ruslanrobotic/Dissertation/Test bench/3DModel_CAD_CAE/Version without libraries/Baugruppe_026.JPG

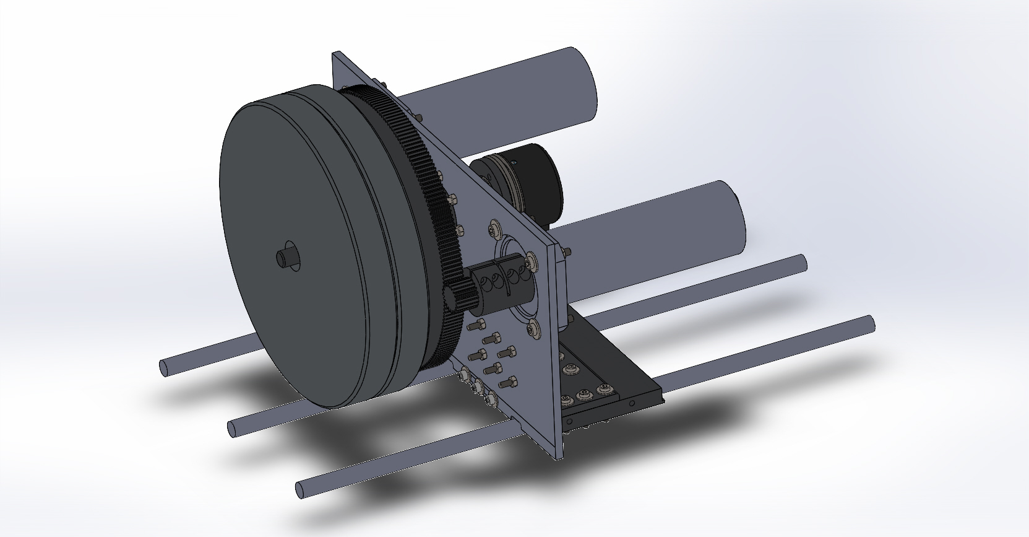
Test bench/3DModel_CAD_CAE/Version without libraries/Baugruppe_026.JPG
