ruslanrobotic/Dissertation/Test bench/3DModel_CAD_CAE/Baugruppe_026.JPG

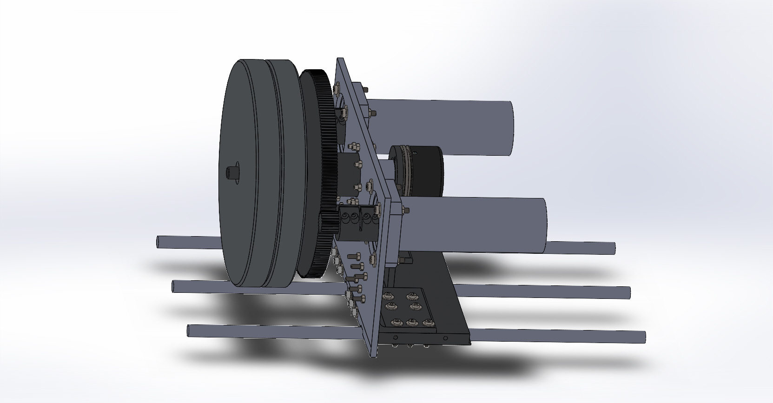
Test bench/3DModel_CAD_CAE/Baugruppe_026.JPG
