ruslanrobotic/Dissertation/Test bench/3DModel_CAD_CAE/Baugruppe_026.SLDASM

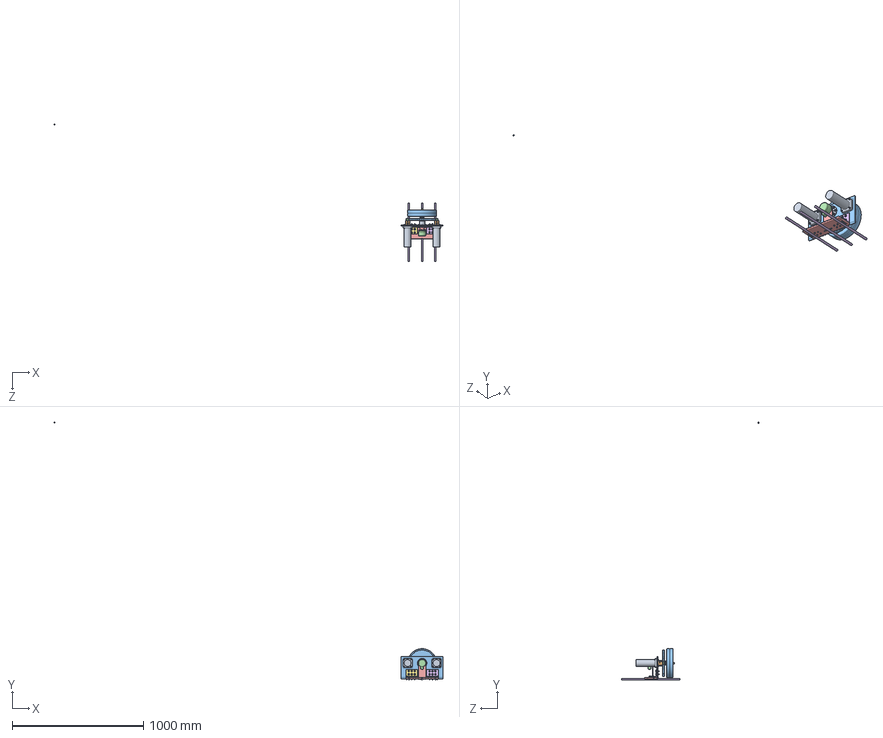
[picture p31: CAD file, 2025-05-02]
Test bench/3DModel_CAD_CAE/Baugruppe_026.SLDASM
2962.5 x 1963.3 x 1046.3 mm
Двигатель KEB B2.SM.000-6200_01 x 2
Вал_двигателя_01 x 2
Platform_001
Circlips 13943A_gost x 2
Bear 8338_200_gost x 2
Bush_2
Shaft_4
Circlips 13942B_gost
Frame_small_stand_2
Washer 6958_1_gost x 51
socket thin pilot cap screw_din x 42
Hex Nut 5929_gost x 8
Platform_2_001
Rail_1 x 3
Washer 6402_3_gost x 6
SC GOST 11738_gost x 10
KTR_105_9_20 x 2
KTR 105_15_28_2
Gear_small_2
Gear_001_i=10_small_z=20 x 2
Sensor_support x 2
Angle_bar
Angle_bar_2
Hex Nut 5915_gost x 35
SC GOST 1491_gost x 3
Kuppling_001 x 2
Load_1 x 2
Sensor
Sensor_clutch
Sensor_shaft
