ruslanrobotic/Dissertation/Test bench/3DModel_CAD_CAE/Version without libraries/Baugruppe_027.SLDASM

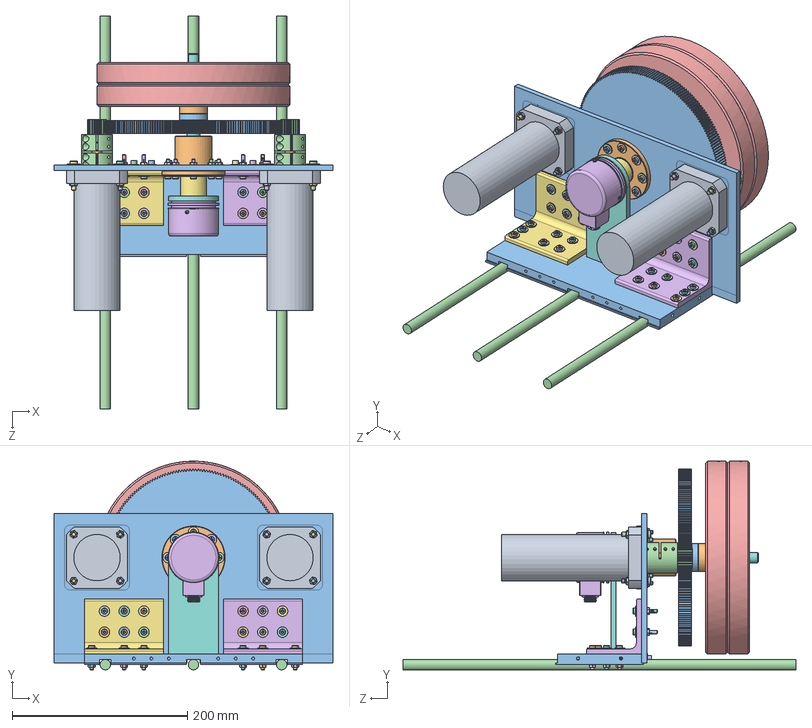
[picture p32: CAD file, 2025-05-02]
Test bench/3DModel_CAD_CAE/Version without libraries/Baugruppe_027.SLDASM
318.0 x 238.0 x 448.0 mm
Двигатель KEB B2.SM.000-6200_01 x 2
Вал_двигателя_01 x 2
Platform_001
Circlips 13943A_gost_2
Bear 8338_200_gost_2
Bear 8338_200_gost_3
Bush_2
Shaft_4
Circlips 13942B_gost_2
Frame_small_stand_2
Washer 6958_1_gost_2
Washer 6958_1_gost_3
Washer 6958_1_gost_4
Washer 6958_1_gost_5
Washer 6958_1_gost_6
Washer 6958_1_gost_7
Washer 6958_1_gost_8
Washer 6958_1_gost_9
socket thin pilot cap screw_din_2
socket thin pilot cap screw_din_3
socket thin pilot cap screw_din_4
socket thin pilot cap screw_din_5
socket thin pilot cap screw_din_6
socket thin pilot cap screw_din_7
socket thin pilot cap screw_din_8
socket thin pilot cap screw_din_9
Hex Nut 5929_gost_2
Hex Nut 5929_gost_3
Hex Nut 5929_gost_4
Hex Nut 5929_gost_5
Hex Nut 5929_gost_6
Hex Nut 5929_gost_7
Hex Nut 5929_gost_8
Hex Nut 5929_gost_9
Platform_2_001
Rail_1 x 3
Washer 6402_3_gost_2
Washer 6402_3_gost_3
Washer 6402_3_gost_4
Washer 6402_3_gost_5
Washer 6402_3_gost_6
Washer 6402_3_gost_7
SC GOST 11738_gost_2
SC GOST 11738_gost_3
SC GOST 11738_gost_4
SC GOST 11738_gost_5
SC GOST 11738_gost_6
SC GOST 11738_gost_7
KTR_105_9_20 x 2
KTR 105_15_28_2
Gear_small_2
Gear_001_i=10_small_z=20 x 2
Circlips 13943A_gost_3
Angle_bar
Angle_bar_2
Washer 6958_1_gost_10
Washer 6958_1_gost_11
Washer 6958_1_gost_12
Washer 6958_1_gost_13
Washer 6958_1_gost_14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
