ruslanrobotic/Dissertation/Test bench/3DModel_CAD_CAE/Shaft_4.SLDPRT

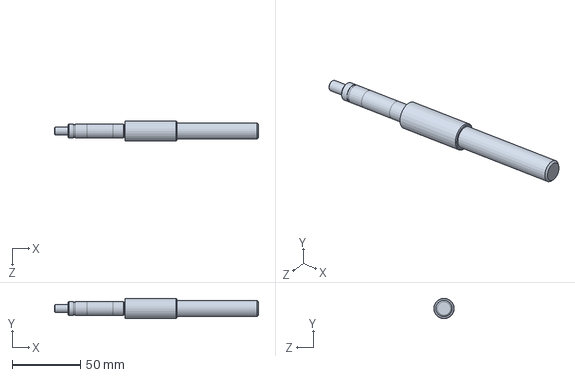
[picture p33: CAD file, 2025-05-02]
Test bench/3DModel_CAD_CAE/Shaft_4.SLDPRT
150.0 x 15.0 x 15.0 mm
