ruslanrobotic/Dissertation/Test bench/3DModel_CAD_CAE/Load_1.SLDPRT

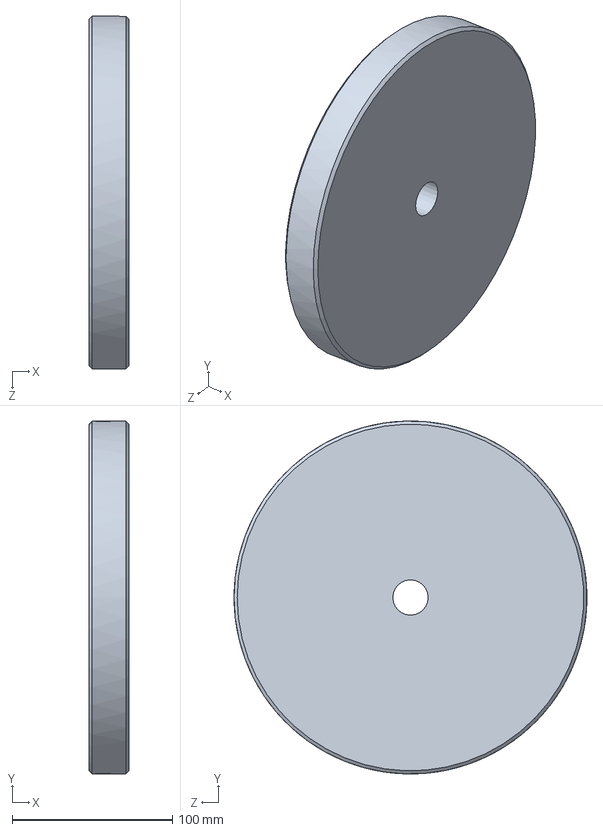
[picture p34: CAD file, 2025-05-02]
Test bench/3DModel_CAD_CAE/Load_1.SLDPRT
25.0 x 219.9 x 220.0 mm
