ruslanrobotic/Dissertation/Test bench/3DModel_CAD_CAE/Angle_bar_2.SLDPRT

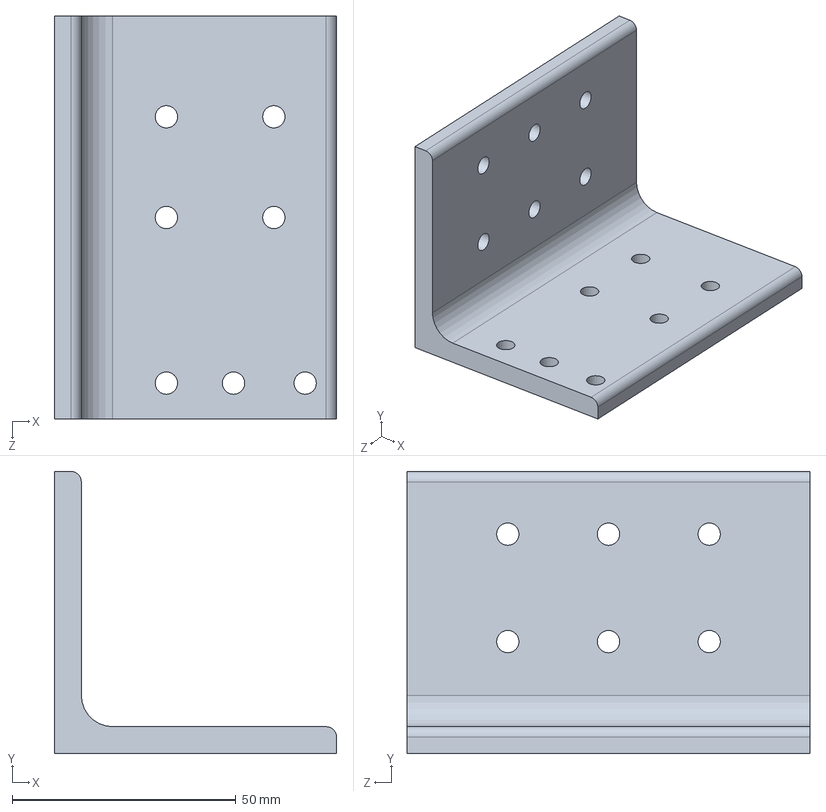
[picture p35: CAD file, 2025-05-02]
Test bench/3DModel_CAD_CAE/Angle_bar_2.SLDPRT
63.0 x 63.0 x 90.0 mm
