ruslanrobotic/Dissertation/Test bench/3DModel_CAD_CAE/Version without libraries/SC GOST 11738_gost_3.SLDPRT

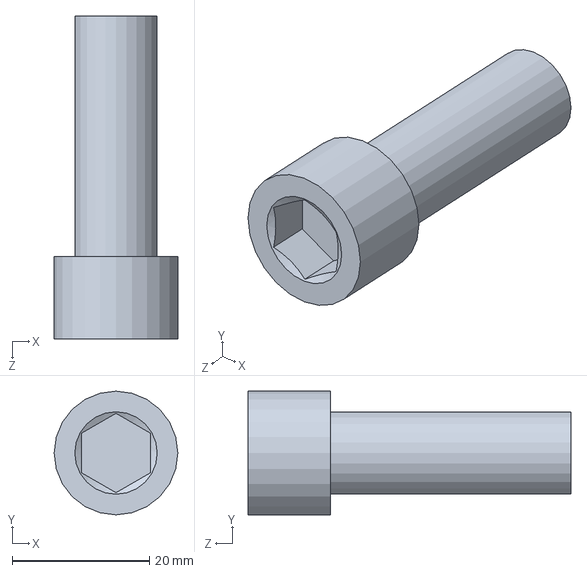
[picture p36: CAD file, 2025-05-02]
Test bench/3DModel_CAD_CAE/Version without libraries/SC GOST 11738_gost_3.SLDPRT
18.0 x 18.0 x 47.0 mm
