ruslanrobotic/Dissertation/Test bench/3DModel_CAD_CAE/Gear_small_2.SLDPRT

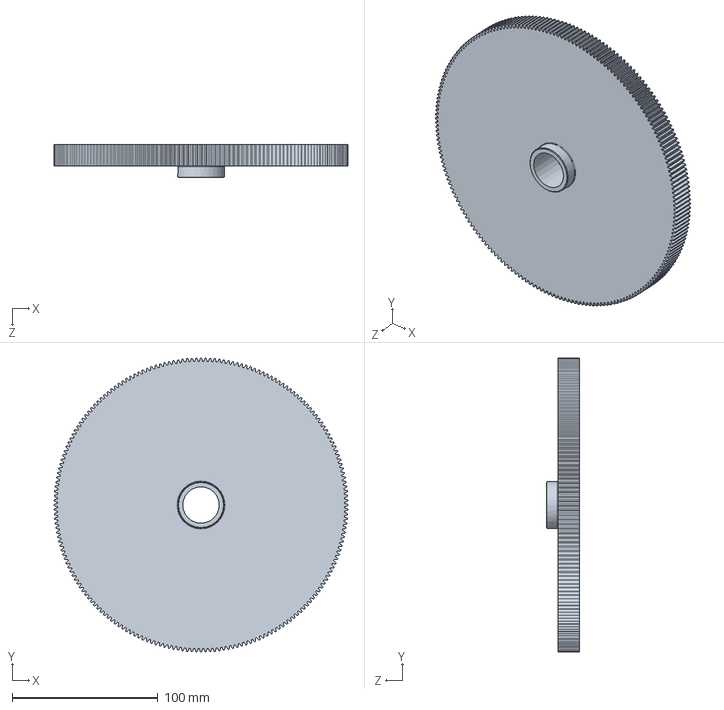
[picture p37: CAD file, 2025-05-02]
Test bench/3DModel_CAD_CAE/Gear_small_2.SLDPRT
202.0 x 202.0 x 23.0 mm
