ruslanrobotic/Dissertation/Test bench/3DModel_CAD_CAE/Sensor_support.SLDPRT

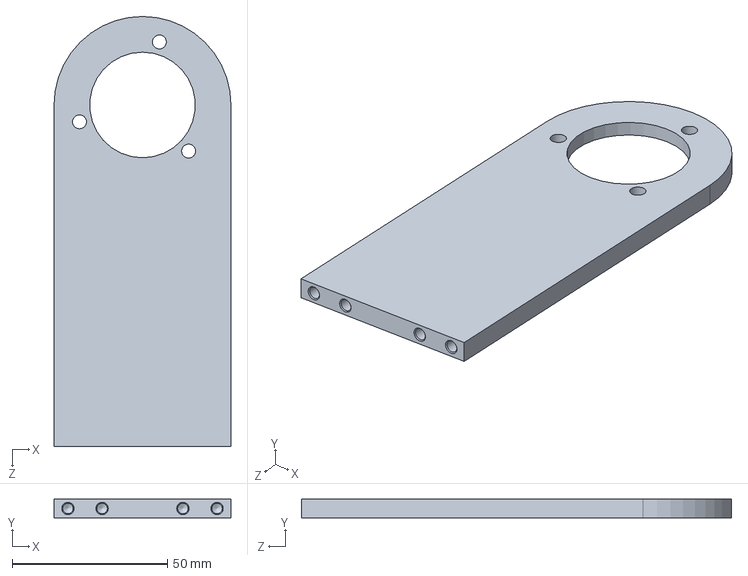
[picture p38: CAD file, 2025-05-02]
Test bench/3DModel_CAD_CAE/Sensor_support.SLDPRT
57.0 x 6.00 x 138.5 mm
