ruslanrobotic/Dissertation/Test bench/3DModel_CAD_CAE/Platform_2_001.SLDPRT

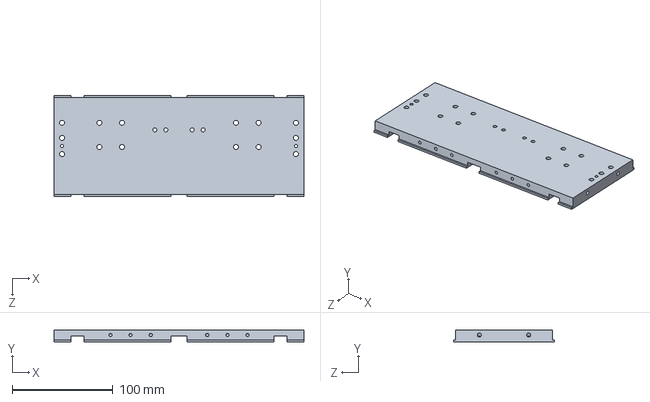
[picture p39: CAD file, 2025-05-02]
Test bench/3DModel_CAD_CAE/Platform_2_001.SLDPRT
248.0 x 12.0 x 100.0 mm
