ruslanrobotic/Dissertation/Test bench/3DModel_CAD_CAE/Version without libraries/Sensor_shaft.SLDPRT

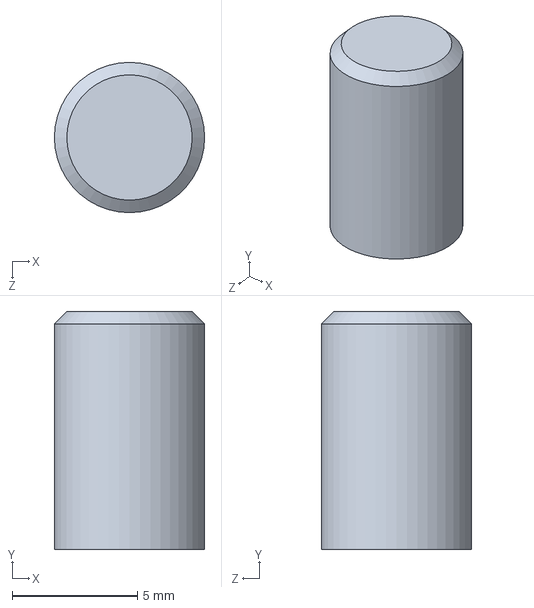
[picture p40: CAD file, 2025-05-02]
Test bench/3DModel_CAD_CAE/Version without libraries/Sensor_shaft.SLDPRT
6.00 x 9.50 x 6.00 mm
