ruslanrobotic/Dissertation/Test bench/3DModel_CAD_CAE/Sensor_clutch.SLDPRT

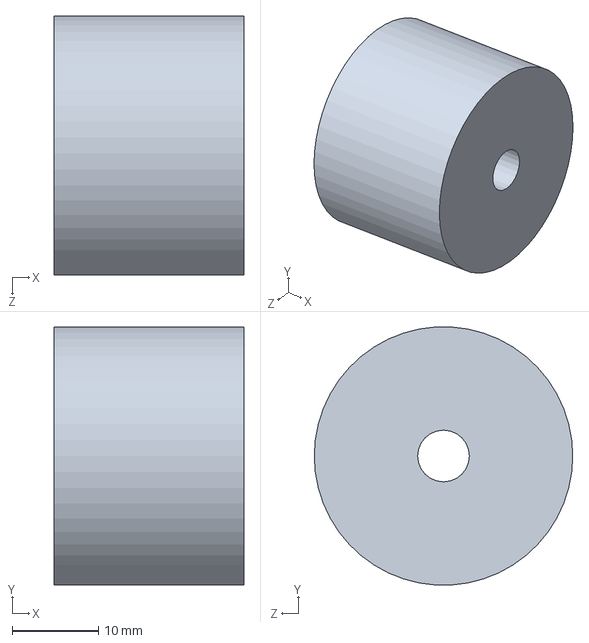
[picture p41: CAD file, 2025-05-02]
Test bench/3DModel_CAD_CAE/Sensor_clutch.SLDPRT
22.0 x 29.9 x 30.0 mm
