ruslanrobotic/Dissertation/Test bench/3DModel_CAD_CAE/Bush_2.SLDPRT

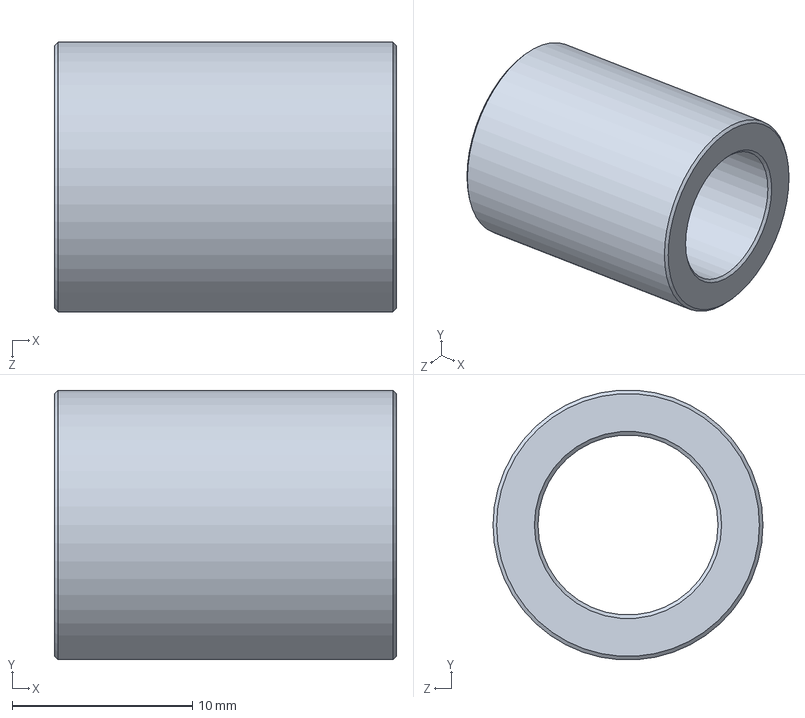
[picture p42: CAD file, 2025-05-02]
Test bench/3DModel_CAD_CAE/Bush_2.SLDPRT
19.0 x 15.0 x 15.0 mm
