ruslanrobotic/Dissertation/Test bench/3DModel_CAD_CAE/Platform_001.SLDPRT

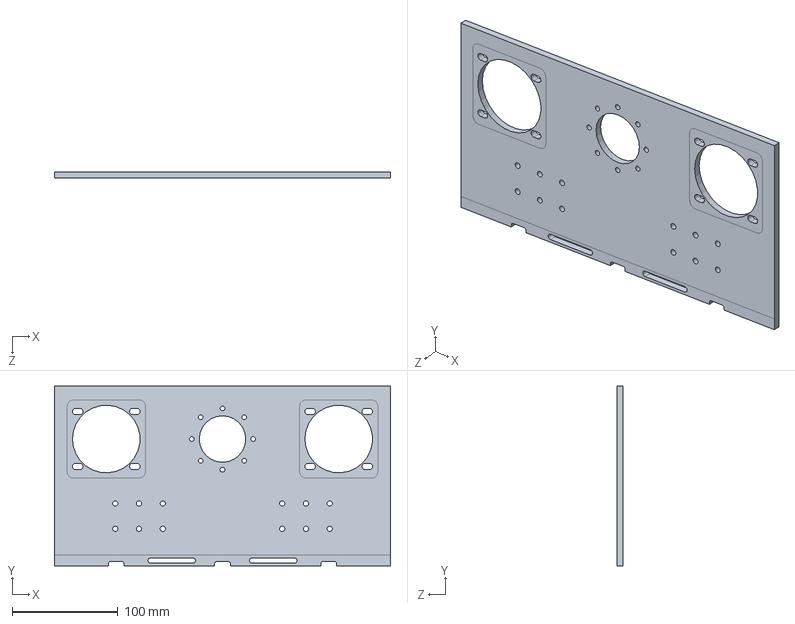
[picture p43: CAD file, 2025-05-02]
Test bench/3DModel_CAD_CAE/Platform_001.SLDPRT
318.0 x 170.0 x 6.00 mm
