ruslanrobotic/Dissertation/Test bench/3DModel_CAD_CAE/Circlips 13942B_gost.SLDPRT

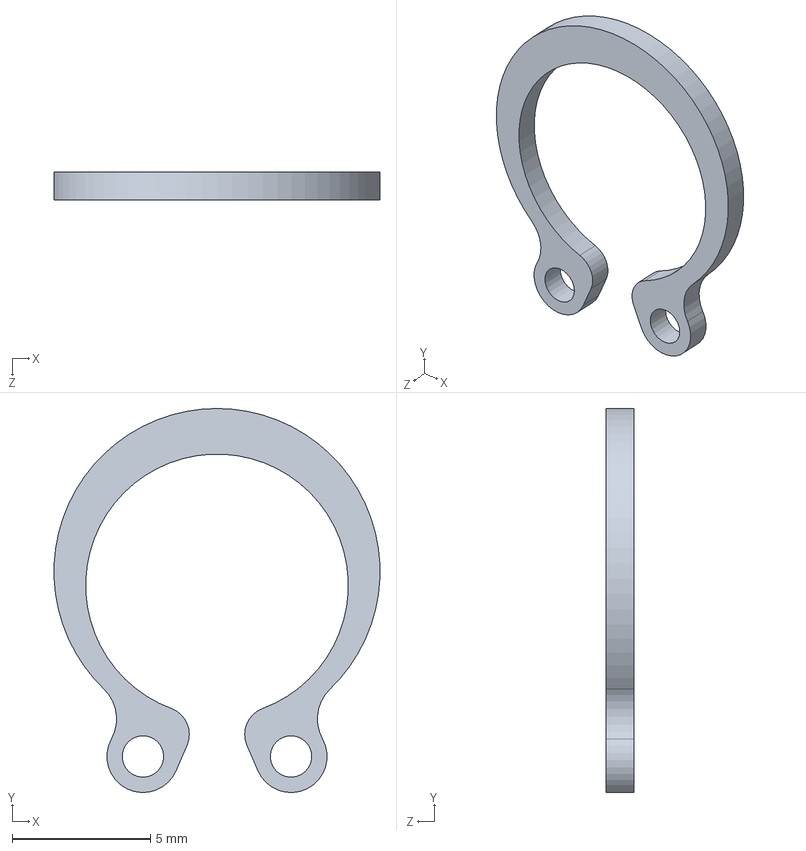
[picture p44: CAD file, 2025-05-02]
Test bench/3DModel_CAD_CAE/Circlips 13942B_gost.SLDPRT
11.8 x 13.9 x 1.00 mm
