ruslanrobotic/Dissertation/Test bench/3DModel_CAD_CAE/Rail_1.SLDPRT

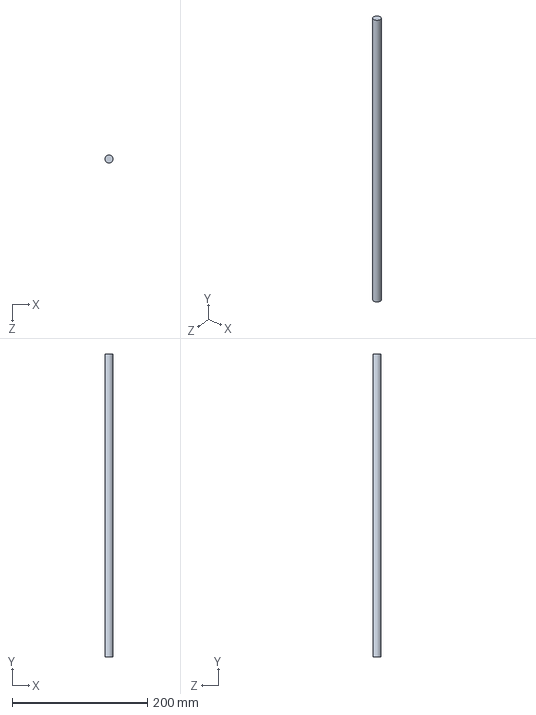
[picture p45: CAD file, 2025-05-02]
Test bench/3DModel_CAD_CAE/Rail_1.SLDPRT
12.0 x 448.0 x 12.0 mm
