ruslanrobotic/Dissertation/Test bench/3DModel_CAD_CAE/Version without libraries/Bear 8338_200_gost_2.SLDPRT

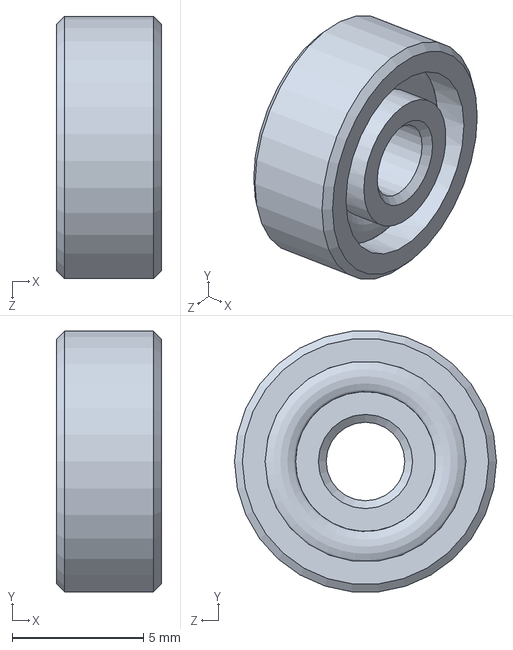
[picture p46: CAD file, 2025-05-02]
Test bench/3DModel_CAD_CAE/Version without libraries/Bear 8338_200_gost_2.SLDPRT
4.00 x 9.95 x 10.0 mm
