ruslanrobotic/Dissertation/Test bench/3DModel_CAD_CAE/Kuppling_001.SLDPRT

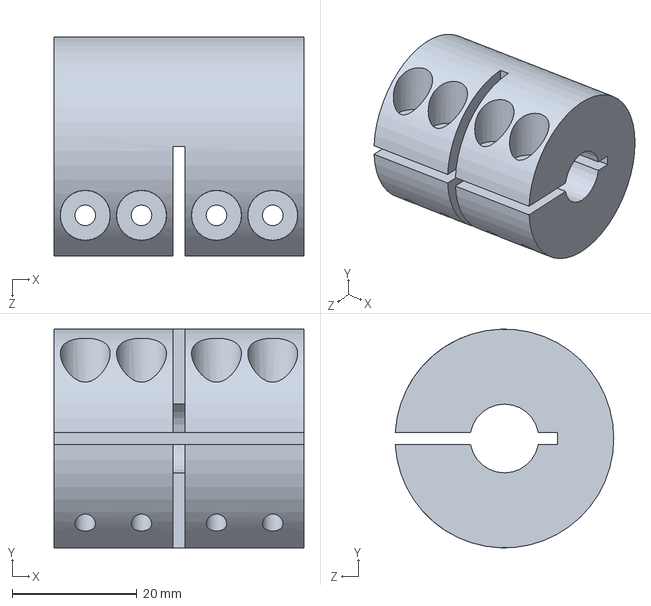
[picture p47: CAD file, 2025-05-02]
Test bench/3DModel_CAD_CAE/Kuppling_001.SLDPRT
40.0 x 35.0 x 35.0 mm
