ruslanrobotic/Dissertation/Test bench/3DModel_CAD_CAE/SC GOST 1491_gost.SLDPRT

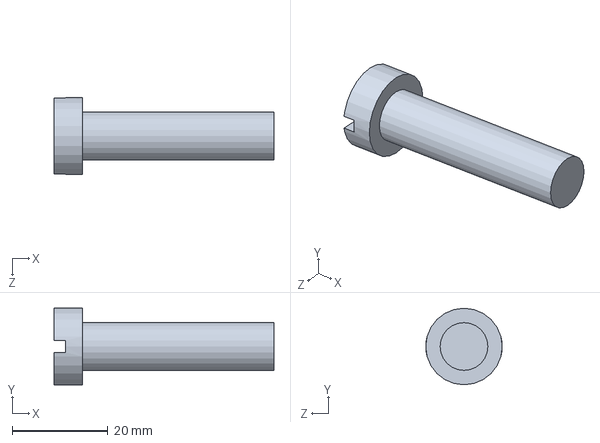
[picture p48: CAD file, 2025-05-02]
Test bench/3DModel_CAD_CAE/SC GOST 1491_gost.SLDPRT
46.0 x 16.0 x 16.0 mm
