ruslanrobotic/Dissertation/Test bench/3DModel_CAD_CAE/Version without libraries/KTR 105_15_28_2.SLDPRT

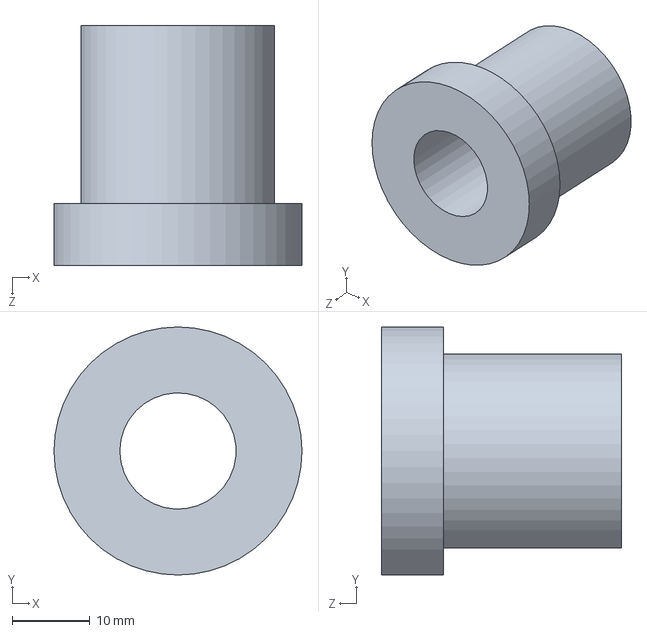
[picture p49: CAD file, 2025-05-02]
Test bench/3DModel_CAD_CAE/Version without libraries/KTR 105_15_28_2.SLDPRT
32.0 x 32.0 x 31.0 mm
