ruslanrobotic/Dissertation/Test bench/3DModel_CAD_CAE/Sensor.SLDPRT

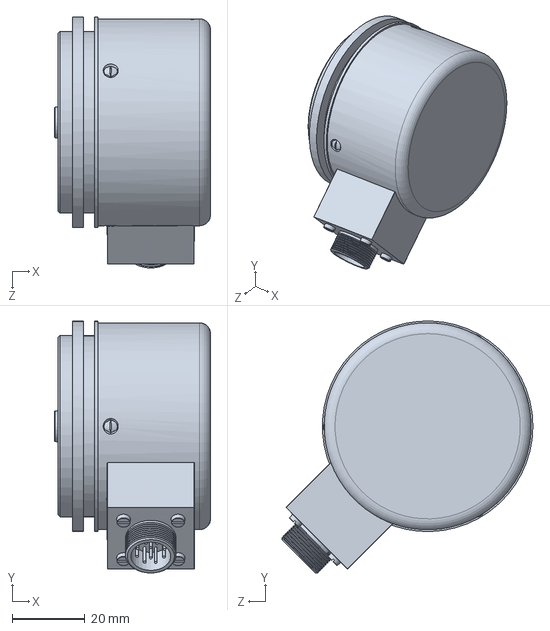
[picture p50: CAD file, 2025-05-02]
Test bench/3DModel_CAD_CAE/Sensor.SLDPRT
43.0 x 69.4 x 69.1 mm
