ruslanrobotic/Dissertation/Test bench/3DModel_CAD_CAE/KTR_105_9_20.SLDPRT

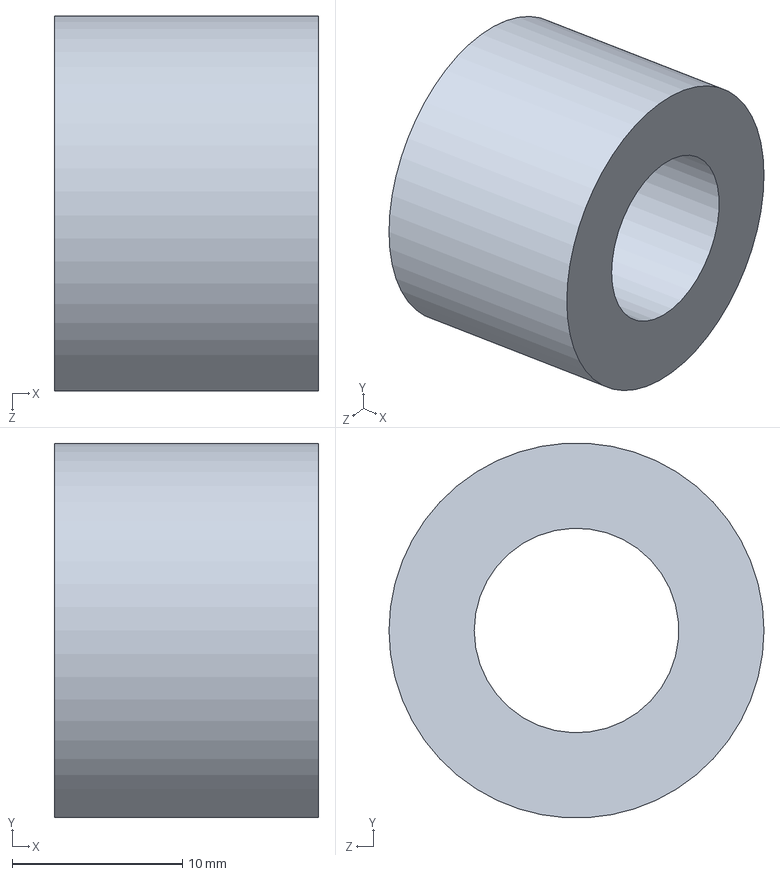
[picture p51: CAD file, 2025-05-02]
Test bench/3DModel_CAD_CAE/KTR_105_9_20.SLDPRT
15.5 x 22.0 x 22.0 mm
