ruslanrobotic/Dissertation/Test bench/3DModel_CAD_CAE/Circlips 13943A_gost.SLDPRT

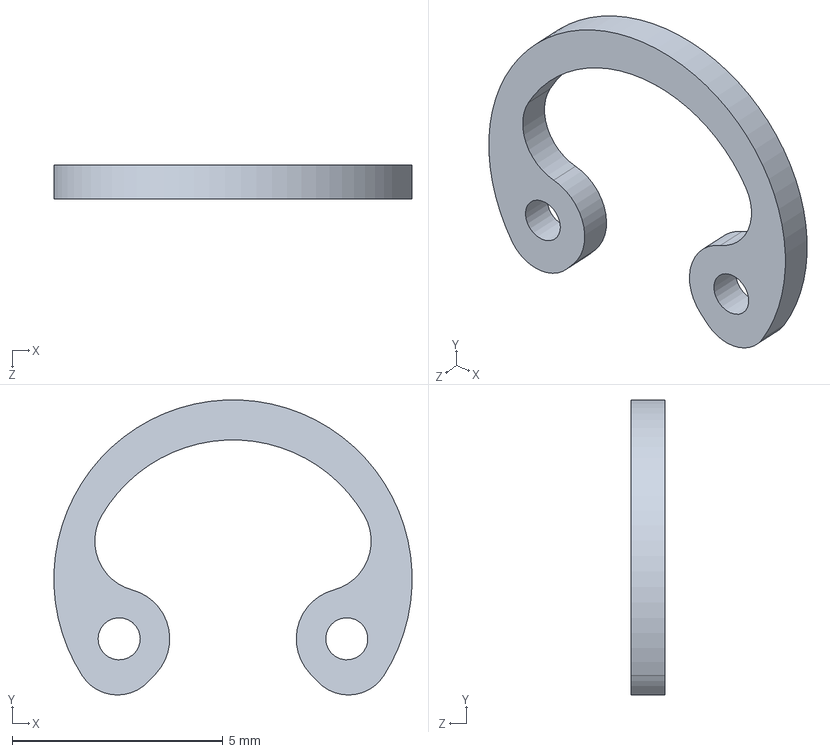
[picture p52: CAD file, 2025-05-02]
Test bench/3DModel_CAD_CAE/Circlips 13943A_gost.SLDPRT
8.49 x 7.00 x 0.8 mm
