ruslanrobotic/Dissertation/Test bench/3DModel_CAD_CAE/Frame_small_stand_2.SLDPRT

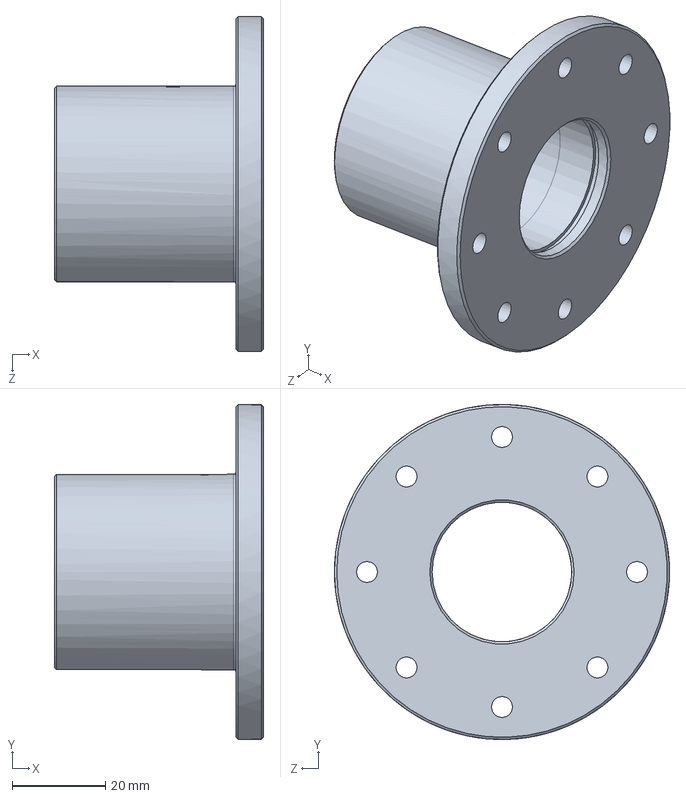
[picture p53: CAD file, 2025-05-02]
Test bench/3DModel_CAD_CAE/Frame_small_stand_2.SLDPRT
45.0 x 72.0 x 72.0 mm
