ruslanrobotic/Dissertation/Test bench/3DModel_CAD_CAE/Gear_001_i=10_small_z=20.SLDPRT

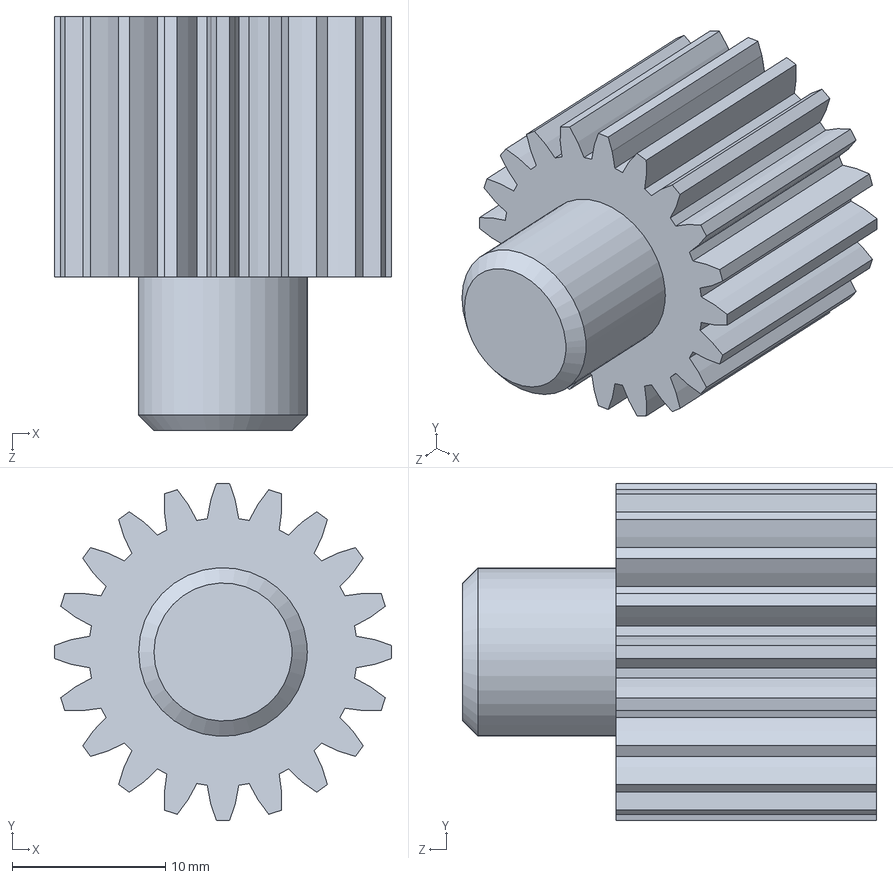
[picture p54: CAD file, 2025-05-02]
Test bench/3DModel_CAD_CAE/Gear_001_i=10_small_z=20.SLDPRT
22.0 x 22.0 x 27.0 mm
