ruslanrobotic/Dissertation/(list of files, cad)

Other CAD files:
Test bench/3DModel_CAD_CAE/Version without libraries/Baugruppe_026.SLDASM
Test bench/3DModel_CAD_CAE/Вал_двигателя_01.SLDPRT
Test bench/3DModel_CAD_CAE/Version without libraries/Angle_bar.SLDPRT
Test bench/3DModel_CAD_CAE/Двигатель KEB B2.SM.000-6200_01.SLDPRT
Test bench/3DModel_CAD_CAE/Bear 8338_200_gost.SLDPRT
Test bench/3DModel_CAD_CAE/SC GOST 11738_gost.SLDPRT
Test bench/3DModel_CAD_CAE/Version without libraries/SC GOST 11738_gost_5.SLDPRT
Test bench/3DModel_CAD_CAE/Version without libraries/SC GOST 11738_gost_4.SLDPRT
Test bench/3DModel_CAD_CAE/Angle_bar.SLDPRT
Test bench/3DModel_CAD_CAE/Version without libraries/Двигатель KEB B2.SM.000-6200_01.SLDPRT
Test bench/3DModel_CAD_CAE/Version without libraries/Circlips 13942B_gost_2.SLDPRT
Test bench/3DModel_CAD_CAE/Version without libraries/SC GOST 11738_gost_2.SLDPRT
Test bench/3DModel_CAD_CAE/Version without libraries/Circlips 13943A_gost_3.SLDPRT
Test bench/3DModel_CAD_CAE/Version without libraries/SC GOST 11738_gost_7.SLDPRT
Test bench/3DModel_CAD_CAE/Version without libraries/SC GOST 11738_gost_6.SLDPRT
Test bench/3DModel_CAD_CAE/Version without libraries/Kuppling_001.SLDPRT
Test bench/3DModel_CAD_CAE/Version without libraries/Circlips 13943A_gost_2.SLDPRT
Test bench/3DModel_CAD_CAE/Version without libraries/Bear 8338_200_gost.SLDPRT
Test bench/3DModel_CAD_CAE/Version without libraries/Bear 8338_200_gost_3.SLDPRT
Test bench/3DModel_CAD_CAE/Version without libraries/Вал_двигателя_01.SLDPRT
Test bench/3DModel_CAD_CAE/Hex Nut 5915_gost.SLDPRT
Test bench/3DModel_CAD_CAE/Hex Nut 5929_gost.SLDPRT
Test bench/3DModel_CAD_CAE/Version without libraries/Hex Nut 5915_gost.SLDPRT
Test bench/3DModel_CAD_CAE/Version without libraries/Hex Nut 5915_gost_10.SLDPRT
Test bench/3DModel_CAD_CAE/Version without libraries/Hex Nut 5915_gost_11.SLDPRT
Test bench/3DModel_CAD_CAE/Version without libraries/Hex Nut 5915_gost_12.SLDPRT
Test bench/3DModel_CAD_CAE/Version without libraries/Hex Nut 5915_gost_13.SLDPRT
Test bench/3DModel_CAD_CAE/Version without libraries/Hex Nut 5915_gost_14.SLDPRT
Test bench/3DModel_CAD_CAE/Version without libraries/Hex Nut 5915_gost_15.SLDPRT
Test bench/3DModel_CAD_CAE/Version without libraries/Hex Nut 5915_gost_16.SLDPRT
Test bench/3DModel_CAD_CAE/Version without libraries/Hex Nut 5915_gost_17.SLDPRT
Test bench/3DModel_CAD_CAE/Version without libraries/Hex Nut 5915_gost_18.SLDPRT
Test bench/3DModel_CAD_CAE/Version without libraries/Hex Nut 5915_gost_19.SLDPRT
Test bench/3DModel_CAD_CAE/Version without libraries/Hex Nut 5915_gost_2.SLDPRT
Test bench/3DModel_CAD_CAE/Version without libraries/Hex Nut 5915_gost_20.SLDPRT
Test bench/3DModel_CAD_CAE/Version without libraries/Hex Nut 5915_gost_21.SLDPRT
Test bench/3DModel_CAD_CAE/Version without libraries/Hex Nut 5915_gost_22.SLDPRT
Test bench/3DModel_CAD_CAE/Version without libraries/Hex Nut 5915_gost_23.SLDPRT
Test bench/3DModel_CAD_CAE/Version without libraries/Hex Nut 5915_gost_24.SLDPRT
Test bench/3DModel_CAD_CAE/Version without libraries/Hex Nut 5915_gost_25.SLDPRT
Test bench/3DModel_CAD_CAE/Version without libraries/Hex Nut 5915_gost_26.SLDPRT
Test bench/3DModel_CAD_CAE/Version without libraries/Hex Nut 5915_gost_27.SLDPRT
Test bench/3DModel_CAD_CAE/Version without libraries/Hex Nut 5915_gost_28.SLDPRT
Test bench/3DModel_CAD_CAE/Version without libraries/Hex Nut 5915_gost_29.SLDPRT
Test bench/3DModel_CAD_CAE/Version without libraries/Hex Nut 5915_gost_3.SLDPRT
Test bench/3DModel_CAD_CAE/Version without libraries/Hex Nut 5915_gost_30.SLDPRT
Test bench/3DModel_CAD_CAE/Version without libraries/Hex Nut 5915_gost_31.SLDPRT
Test bench/3DModel_CAD_CAE/Version without libraries/Hex Nut 5915_gost_32.SLDPRT
Test bench/3DModel_CAD_CAE/Version without libraries/Hex Nut 5915_gost_33.SLDPRT
Test bench/3DModel_CAD_CAE/Version without libraries/Hex Nut 5915_gost_34.SLDPRT
Test bench/3DModel_CAD_CAE/Version without libraries/Hex Nut 5915_gost_35.SLDPRT
Test bench/3DModel_CAD_CAE/Version without libraries/Hex Nut 5915_gost_4.SLDPRT
Test bench/3DModel_CAD_CAE/Version without libraries/Hex Nut 5915_gost_5.SLDPRT
Test bench/3DModel_CAD_CAE/Version without libraries/Hex Nut 5915_gost_6.SLDPRT
Test bench/3DModel_CAD_CAE/Version without libraries/Hex Nut 5915_gost_7.SLDPRT
Test bench/3DModel_CAD_CAE/Version without libraries/Hex Nut 5915_gost_8.SLDPRT
Test bench/3DModel_CAD_CAE/Version without libraries/Hex Nut 5915_gost_9.SLDPRT
Test bench/3DModel_CAD_CAE/Version without libraries/Hex Nut 5929_gost.SLDPRT
Test bench/3DModel_CAD_CAE/Version without libraries/Hex Nut 5929_gost_2.SLDPRT
Test bench/3DModel_CAD_CAE/Version without libraries/Hex Nut 5929_gost_3.SLDPRT
Test bench/3DModel_CAD_CAE/Version without libraries/Hex Nut 5929_gost_4.SLDPRT
Test bench/3DModel_CAD_CAE/Version without libraries/Hex Nut 5929_gost_5.SLDPRT
Test bench/3DModel_CAD_CAE/Version without libraries/Hex Nut 5929_gost_6.SLDPRT
Test bench/3DModel_CAD_CAE/Version without libraries/Hex Nut 5929_gost_7.SLDPRT
Test bench/3DModel_CAD_CAE/Version without libraries/Hex Nut 5929_gost_8.SLDPRT
Test bench/3DModel_CAD_CAE/Version without libraries/Hex Nut 5929_gost_9.SLDPRT
Test bench/3DModel_CAD_CAE/Version without libraries/Washer 6402_3_gost.SLDPRT
Test bench/3DModel_CAD_CAE/Version without libraries/Washer 6402_3_gost_2.SLDPRT
Test bench/3DModel_CAD_CAE/Version without libraries/Washer 6402_3_gost_3.SLDPRT
Test bench/3DModel_CAD_CAE/Version without libraries/Washer 6402_3_gost_4.SLDPRT
Test bench/3DModel_CAD_CAE/Version without libraries/Washer 6402_3_gost_5.SLDPRT
Test bench/3DModel_CAD_CAE/Version without libraries/Washer 6402_3_gost_6.SLDPRT
Test bench/3DModel_CAD_CAE/Version without libraries/Washer 6402_3_gost_7.SLDPRT
Test bench/3DModel_CAD_CAE/Version without libraries/Washer 6958_1_gost_10.SLDPRT
Test bench/3DModel_CAD_CAE/Version without libraries/Washer 6958_1_gost_11.SLDPRT
Test bench/3DModel_CAD_CAE/Version without libraries/Washer 6958_1_gost_12.SLDPRT
Test bench/3DModel_CAD_CAE/Version without libraries/Washer 6958_1_gost_13.SLDPRT
Test bench/3DModel_CAD_CAE/Version without libraries/Washer 6958_1_gost_14.SLDPRT
Test bench/3DModel_CAD_CAE/Version without libraries/Washer 6958_1_gost_15.SLDPRT
Test bench/3DModel_CAD_CAE/Version without libraries/Washer 6958_1_gost_16.SLDPRT
Test bench/3DModel_CAD_CAE/Version without libraries/Washer 6958_1_gost_17.SLDPRT
Test bench/3DModel_CAD_CAE/Version without libraries/Washer 6958_1_gost_18.SLDPRT
Test bench/3DModel_CAD_CAE/Version without libraries/Washer 6958_1_gost_19.SLDPRT
Test bench/3DModel_CAD_CAE/Version without libraries/Washer 6958_1_gost_2.SLDPRT
Test bench/3DModel_CAD_CAE/Version without libraries/Washer 6958_1_gost_20.SLDPRT
Test bench/3DModel_CAD_CAE/Version without libraries/Washer 6958_1_gost_21.SLDPRT
Test bench/3DModel_CAD_CAE/Version without libraries/Washer 6958_1_gost_22.SLDPRT
Test bench/3DModel_CAD_CAE/Version without libraries/Washer 6958_1_gost_23.SLDPRT
Test bench/3DModel_CAD_CAE/Version without libraries/Washer 6958_1_gost_24.SLDPRT
Test bench/3DModel_CAD_CAE/Version without libraries/Washer 6958_1_gost_25.SLDPRT
Test bench/3DModel_CAD_CAE/Version without libraries/Washer 6958_1_gost_26.SLDPRT
Test bench/3DModel_CAD_CAE/Version without libraries/Washer 6958_1_gost_27.SLDPRT
Test bench/3DModel_CAD_CAE/Version without libraries/Washer 6958_1_gost_28.SLDPRT
Test bench/3DModel_CAD_CAE/Version without libraries/Washer 6958_1_gost_29.SLDPRT
Test bench/3DModel_CAD_CAE/Version without libraries/Washer 6958_1_gost_3.SLDPRT
Test bench/3DModel_CAD_CAE/Version without libraries/Washer 6958_1_gost_30.SLDPRT
Test bench/3DModel_CAD_CAE/Version without libraries/Washer 6958_1_gost_31.SLDPRT
Test bench/3DModel_CAD_CAE/Version without libraries/Washer 6958_1_gost_32.SLDPRT
Test bench/3DModel_CAD_CAE/Version without libraries/Washer 6958_1_gost_33.SLDPRT
Test bench/3DModel_CAD_CAE/Version without libraries/Washer 6958_1_gost_34.SLDPRT
Test bench/3DModel_CAD_CAE/Version without libraries/Washer 6958_1_gost_35.SLDPRT
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
