ruslanrobotic/Dissertation/Test bench/Mathcad - Calculation of parameters of Braking resistor.pdf

i | 10 := | передаточное отношение механической передачи стенда
Iдатчик_1_LIR158 | 1.7 10- 6
× | 1.7 10- 6
:= | = | ´ | kg m2 ×
Iнагрузка_2_D16T := 0.01589071 | kg m2
× | 2.5 kg × | Д16Т

I

ktr_105x12x22 := 0.00000173 | | | kg m2
× | муфта
IKLFF015 := 0.00001214 | | | kg m2
× | муфта

I

основной_вал_Ст45_1 := 0.00000276 | kg m2
| | | ×

I

зубчатое_колесо_Ст45_1 := 0.01838736 | kg m2
| | | ×

I

втулка_между_подш_Ст45_1 := 0.00000059 | kg m2
| | | ×
Iмуфта_датч_LIR801_1 | 3 10- 6
:= × | kg m2
| | | ×
Iшестерня_Ст45_1 := 0.00000223 | kg m2
| | | ×
Iжёсткая_муфта_1 := 0.00003966 | kg m2
| | | ×

Момент инерции ротора двигателя и нагрузки основного следящего привода:

Jн1

Iжёсткая_муфта_1 Iшестерня_Ст45_1 +

Iдатчик_1_LIR158 Iмуфта_датч_LIR801_1 + | I

втулка +
:= | +

5.43814 10- 4
´

J

st | 5.43814 10- 4
:= | ´ | kg m2
×

n
1

:= 4000

об
мин

начальная скорость замедления

n
2
:= 0 | конечная скорость замедления
Mторм := 1 | Н*м - номинальный момент двигателя

t

2π J

st × n
1

×
60 Mторм ×
:= | = 0.228 | с - требуемое время торможения и значение тормозного цикла для обеспечения заданного момента торможения

t

br := 0.228 | с - желаемое время замедления
MBmax | 0.5

J

st n
1

n

2 ( - ) ×

9.55 tbr ×

:= | + | = 1.499 | Н*м - максимальный момент торможения

Pbmax

MBmax n
1

n

2 ( - ) ×

9.55

:= | = 627.86 | Вт - максимальная мощность торможения

PrMot := 620 | Вт - мощность двигателя
ηgear := 0.97 | КПД цилиндрической зубчатой передачи
k | 0.25 := | коэффициент при мощности двигателя меньше 1.5 кВт
Pel | Pbmax kPrMot - × | 1 ηgear ( - | ) Pbmax := | - | × | = 454.024 | максимальная электрическая
мощность торможения

UB

:= 380 В - напряжение на шине постоянного тока для преобразователя частоты на 220 В

Rb

UB

2

Pel

:= | = 318.045 | максимально допустимое значение тормозного сопротивления

I
b

UB
Rb
:= | = 1.195 | А - тормозной ток
ED := 100 | % - период включения тормозного резистора

f
k
:= 1 | коэффициент, зависящий от продолжительности включения. При ED=100%
PelAve | Pel
| f k
:= | = 454.024 | номинальная мощность тормозного резистора

Таким образом, необходимо выбрать резистор исходя из следующих параметров:

R | Rb
£ | Rb
= 318.045 | Ом
PelAve = 454.024 | номинальная мощность тормозного резистора
Pel = 454.024 | максимальная электрическая мощность торможения

а также
ED = 100 % - период включения тормозного резистора

I
b

= 1.195 А - тормозной ток

t

br = 0.228 с - время торможения

_между_подш_Ст45_1 I

зубчатое_колесо_Ст45_1 + | I
основной_вал_Ст45_1 + | IKLFF015 + | 2Iktr_105x12x22 + ×

i

2

2Iнагрузка_2_D16T + ×
5.438 10- 4
= | ´ | kg m2
×
