ruslanrobotic/Dissertation/Program/Results/13.05.21/AAA.csv

takt | q1 | q2 | q2p
0 | 264.000000 | -11.000000 | 820.382690
1 | 433.000000 | -13.000000 | 1640.743530
2 | 372.000000 | -12.000000 | 2461.061035
3 | 161.000000 | -2.000000 | 3281.312744
4 | -298.000000 | 23.000000 | 4101.477539
5 | -969.000000 | 57.000000 | 4921.533203
6 | -1813.000000 | 91.000000 | 5741.458008
7 | -2928.000000 | 126.000000 | 6561.229980
8 | -4157.000000 | 172.000000 | 7380.828125
9 | -5374.000000 | 219.000000 | 8200.230469
10 | -6621.000000 | 269.000000 | 9019.415039
11 | -7820.000000 | 318.000000 | 9838.359375
12 | -8922.000000 | 363.000000 | 10657.042969
13 | -9976.000000 | 406.000000 | 11475.443359
14 | -10953.000000 | 446.000000 | 12293.538086
15 | -11864.000000 | 484.000000 | 13111.307617
16 | -12775.000000 | 522.000000 | 13928.727539
17 | -13664.000000 | 559.000000 | 14745.777344
18 | -14519.000000 | 593.000000 | 15562.435547
19 | -15379.000000 | 629.000000 | 16378.679688
20 | -16216.000000 | 664.000000 | 17194.488281
21 | -17048.000000 | 698.000000 | 18009.839844
22 | -17918.000000 | 734.000000 | 18824.712891
23 | -18771.000000 | 768.000000 | 19639.085938
24 | -19618.000000 | 802.000000 | 20452.937500
25 | -20483.000000 | 838.000000 | 21266.246094
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
