ruslanrobotic/Dissertation/Program/Results/13.05.21/AAB.csv

takt | q1 | q2 | q2p
0 | 276.000000 | -11.000000 | 820.382690
1 | 457.000000 | -15.000000 | 1640.743530
2 | 470.000000 | -16.000000 | 2461.061035
3 | 369.000000 | -14.000000 | 3281.312744
4 | 136.000000 | -5.000000 | 4101.477539
5 | -172.000000 | 8.000000 | 4921.533203
6 | -516.000000 | 22.000000 | 5741.458008
7 | -932.000000 | 39.000000 | 6561.229980
8 | -1364.000000 | 56.000000 | 7380.828125
9 | -1785.000000 | 73.000000 | 8200.230469
10 | -2223.000000 | 91.000000 | 9019.415039
11 | -2674.000000 | 111.000000 | 9838.359375
12 | -3145.000000 | 130.000000 | 10657.042969
13 | -3680.000000 | 152.000000 | 11475.443359
14 | -4248.000000 | 174.000000 | 12293.538086
15 | -4843.000000 | 198.000000 | 13111.307617
16 | -5474.000000 | 224.000000 | 13928.727539
17 | -6109.000000 | 251.000000 | 14745.777344
18 | -6762.000000 | 277.000000 | 15562.435547
19 | -7437.000000 | 305.000000 | 16378.679688
20 | -8115.000000 | 332.000000 | 17194.488281
21 | -8828.000000 | 361.000000 | 18009.839844
22 | -9578.000000 | 392.000000 | 18824.712891
23 | -10338.000000 | 423.000000 | 19639.085938
24 | -11117.000000 | 455.000000 | 20452.937500
25 | -11904.000000 | 487.000000 | 21266.246094
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
