ruslanrobotic/Dissertation/Program/Results/13.05.21/AAC.csv

takt | q1 | q2 | q2p
0 | 280.000000 | -11.000000 | -21.535997
1 | 550.000000 | -17.000000 | 0.865710
2 | 640.000000 | -12.000000 | 23.266891
3 | 591.000000 | -9.000000 | 45.667271
4 | 440.000000 | -2.000000 | 68.066597
5 | 73.000000 | 12.000000 | 90.464592
6 | -393.000000 | 33.000000 | 112.861008
7 | -985.000000 | 55.000000 | 135.255569
8 | -1724.000000 | 84.000000 | 157.648010
9 | -2518.000000 | 114.000000 | 180.038086
10 | -3376.000000 | 148.000000 | 202.425522
11 | -4288.000000 | 184.000000 | 224.810043
12 | -5202.000000 | 221.000000 | 247.191391
13 | -6122.000000 | 258.000000 | 269.569305
14 | -7049.000000 | 295.000000 | 291.943512
15 | -7969.000000 | 329.000000 | 314.313751
16 | -8841.000000 | 361.000000 | 336.679779
17 | -9640.000000 | 393.000000 | 359.041290
18 | -10377.000000 | 423.000000 | 381.398010
19 | -11016.000000 | 449.000000 | 403.749725
20 | -11581.000000 | 473.000000 | 426.096161
21 | -12089.000000 | 494.000000 | 448.437042
22 | -12517.000000 | 512.000000 | 470.772095
23 | -12920.000000 | 528.000000 | 493.101074
24 | -13272.000000 | 543.000000 | 515.423706
25 | -13582.000000 | 556.000000 | 537.739746
26 | -13879.000000 | 568.000000 | 560.048889
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
