ruslanrobotic/Dissertation/Program/Results/13.05.21/ABA.csv

takt | q1 | q2 | q2p
0 | 244.000000 | -10.000000 | 0.000000
1 | 406.000000 | -13.000000 | 0.000000
2 | 434.000000 | -15.000000 | 0.000000
3 | 373.000000 | -14.000000 | 0.000000
4 | 208.000000 | -8.000000 | 0.000000
5 | 2.000000 | 1.000000 | 0.000000
6 | -187.000000 | 7.000000 | 0.000000
7 | -406.000000 | 15.000000 | 0.000000
8 | -597.000000 | 22.000000 | 0.000000
9 | -713.000000 | 28.000000 | 0.000000
10 | -778.000000 | 30.000000 | 0.000000
11 | -780.000000 | 31.000000 | 0.000000
12 | -726.000000 | 29.000000 | 0.000000
13 | -679.000000 | 28.000000 | 0.000000
14 | -619.000000 | 25.000000 | 0.000000
15 | -545.000000 | 23.000000 | 0.000000
16 | -482.000000 | 20.000000 | 0.000000
17 | -406.000000 | 17.000000 | 0.000000
18 | -331.000000 | 14.000000 | 0.000000
19 | -290.000000 | 12.000000 | 0.000000
20 | -239.000000 | 10.000000 | 0.000000
21 | -195.000000 | 8.000000 | 0.000000
22 | -152.000000 | 7.000000 | 0.000000
23 | -106.000000 | 5.000000 | 0.000000
24 | -70.000000 | 3.000000 | 0.000000
25 | -50.000000 | 3.000000 | 0.000000
26 | -28.000000 | 2.000000 | 0.000000
27 | -17.000000 | 1.000000 | 0.000000
28 | -12.000000 | 1.000000 | 0.000000
29 | -5.000000 | 1.000000 | 0.000000
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
