ruslanrobotic/Dissertation/Program/Results/13.05.21/ABB.csv

takt | q1 | q2 | q2p
0 | 262.000000 | -11.000000 | 0.000000
1 | 450.000000 | -15.000000 | 0.000000
2 | 482.000000 | -17.000000 | 0.000000
3 | 429.000000 | -17.000000 | 0.000000
4 | 268.000000 | -12.000000 | 0.000000
5 | 59.000000 | -2.000000 | 0.000000
6 | -147.000000 | 5.000000 | 0.000000
7 | -381.000000 | 14.000000 | 0.000000
8 | -589.000000 | 22.000000 | 0.000000
9 | -724.000000 | 27.000000 | 0.000000
10 | -801.000000 | 30.000000 | 0.000000
11 | -821.000000 | 32.000000 | 0.000000
12 | -781.000000 | 31.000000 | 0.000000
13 | -742.000000 | 30.000000 | 0.000000
14 | -680.000000 | 27.000000 | 0.000000
15 | -598.000000 | 24.000000 | 0.000000
16 | -526.000000 | 21.000000 | 0.000000
17 | -439.000000 | 18.000000 | 0.000000
18 | -352.000000 | 14.000000 | 0.000000
19 | -292.000000 | 12.000000 | 0.000000
20 | -229.000000 | 9.000000 | 0.000000
21 | -166.000000 | 7.000000 | 0.000000
22 | -118.000000 | 5.000000 | 0.000000
23 | -57.000000 | 2.000000 | 0.000000
24 | -11.000000 | 0.000000 | 0.000000
25 | 16.000000 | 0.000000 | 0.000000
26 | 43.000000 | -1.000000 | 0.000000
27 | 54.000000 | -2.000000 | 0.000000
28 | 54.000000 | -2.000000 | 0.000000
29 | 54.000000 | -2.000000 | 0.000000
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
