ruslanrobotic/Dissertation/Program/Results/13.05.21/ABC.csv

takt | q1 | q2 | q2p
0 | 251.000000 | -11.000000 | 0.000000
1 | 483.000000 | -16.000000 | 0.000000
2 | 600.000000 | -10.000000 | 0.000000
3 | 577.000000 | -11.000000 | 0.000000
4 | 471.000000 | -9.000000 | 0.000000
5 | 278.000000 | -3.000000 | 0.000000
6 | 61.000000 | 8.000000 | 0.000000
7 | -170.000000 | 13.000000 | 0.000000
8 | -433.000000 | 22.000000 | 0.000000
9 | -699.000000 | 30.000000 | 0.000000
10 | -902.000000 | 34.000000 | 0.000000
11 | -1024.000000 | 38.000000 | 0.000000
12 | -1057.000000 | 41.000000 | 0.000000
13 | -999.000000 | 40.000000 | 0.000000
14 | -903.000000 | 35.000000 | 0.000000
15 | -784.000000 | 31.000000 | 0.000000
16 | -635.000000 | 26.000000 | 0.000000
17 | -480.000000 | 20.000000 | 0.000000
18 | -336.000000 | 14.000000 | 0.000000
19 | -196.000000 | 9.000000 | 0.000000
20 | -78.000000 | 5.000000 | 0.000000
21 | 30.000000 | 5.000000 | 0.000000
22 | 118.000000 | 4.000000 | 0.000000
23 | 183.000000 | 2.000000 | 0.000000
24 | 226.000000 | 0.000000 | 0.000000
25 | 232.000000 | -1.000000 | 0.000000
26 | 218.000000 | -1.000000 | 0.000000
27 | 175.000000 | -1.000000 | 0.000000
28 | 127.000000 | 2.000000 | 0.000000
29 | 63.000000 | 5.000000 | 0.000000
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
