ruslanrobotic/Dissertation/Test bench/Temporary/Principal scheme 017.jpg

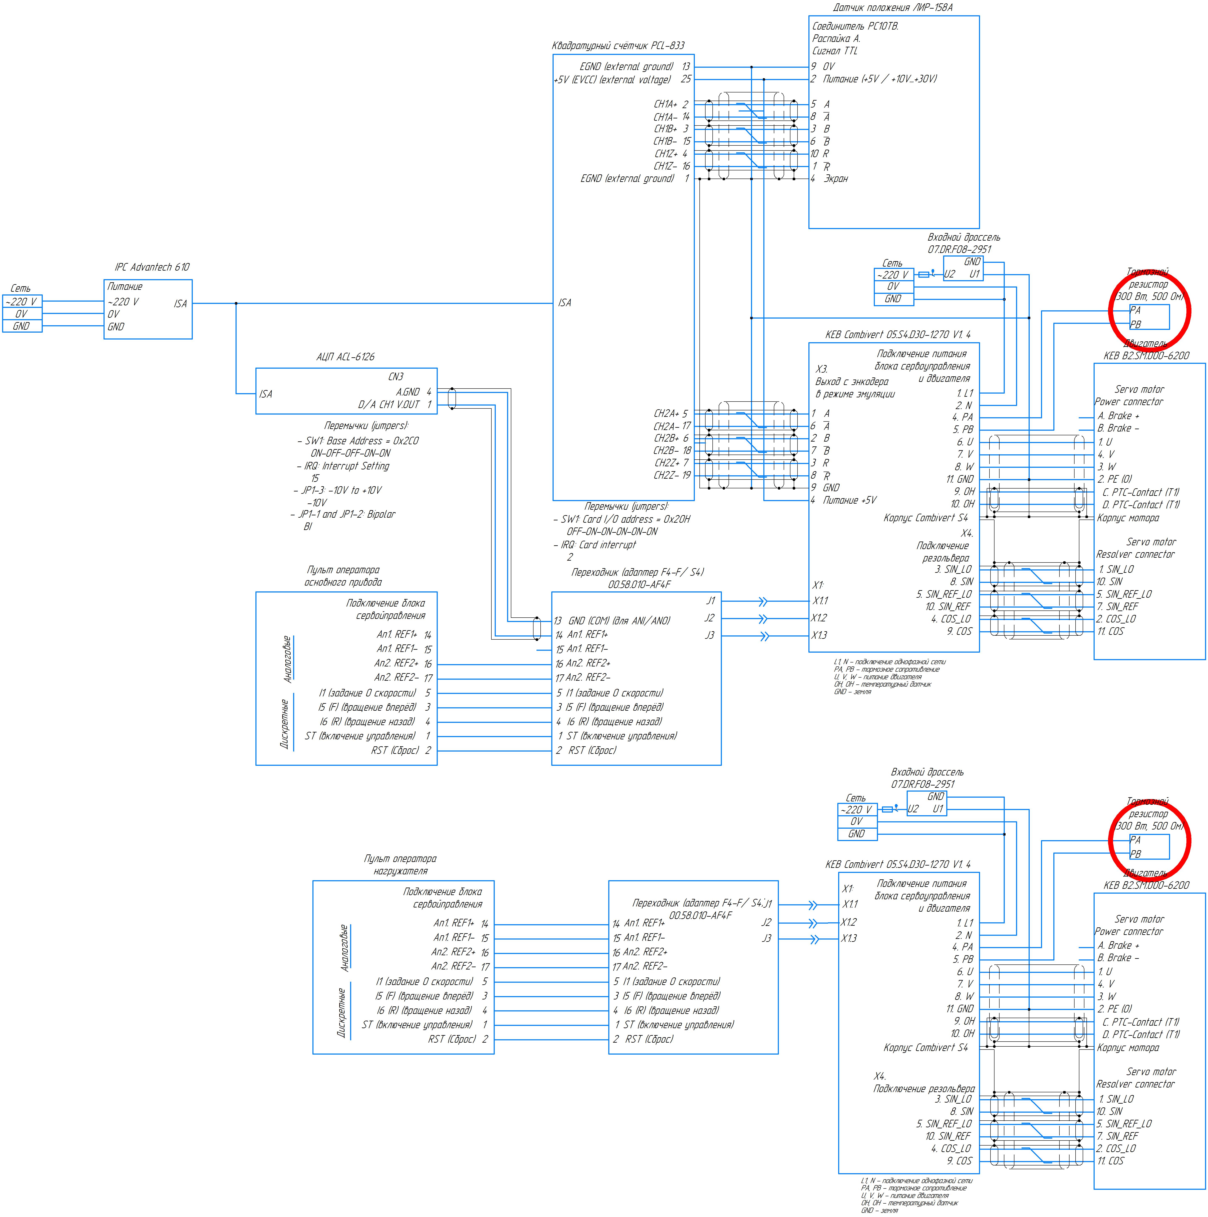
Test bench/Temporary/Principal scheme 017.jpg
