ruslanrobotic/Dissertation/Test bench/Drawings/Additional gear shaft.pdf

À

Á

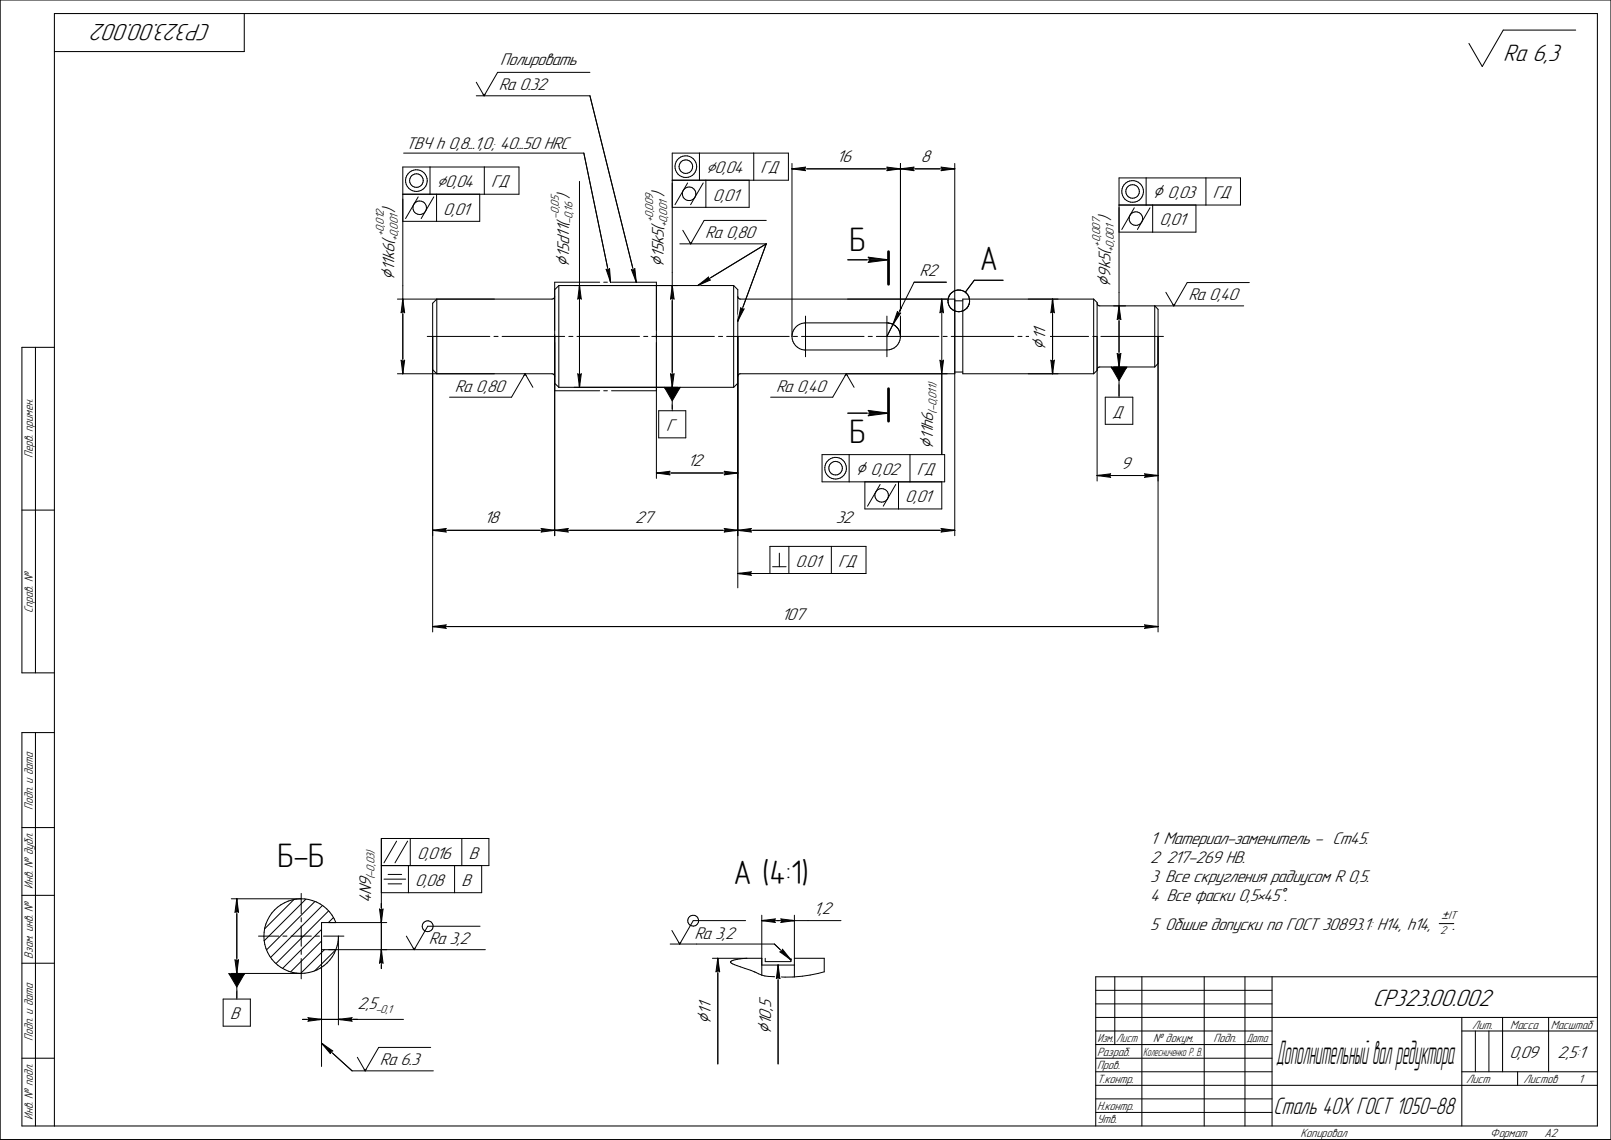
[picture p142: page 1]
Ïîëèðîâàòü; ÒÂ× h 0,8...1,0; 40...50 HRC; Êîïèðîâàë; Ôîðìàò

Èíâ. ¹ ïîäë. Ïîäï. è äàòà Âçàì. èíâ. ¹ Èíâ. ¹ äóáë. Ïîäï. è äàòà Ñïðàâ. ¹ Ïåðâ. ïðèìåí.

1 Ìàòåðèàë-çàìåíèòåëü - Ñò45.
3 Âñå ñêðóãëåíèÿ ðàäèóñîì R 0,5.
Å. 5 Îáøèå äîïóñêè ïî ÃÎÑÒ 30893.1: H14, h14,
4 Âñå ôàñêè 0,5•45

0,016 | Â
0,08 | Â

Äîïîëíèòåëüíûé âàë ðåäóêòîðà | Ëèò. | Ìàññà | Ìàñøòàá

Èçì. Ëèñò | ¹ äîêóì. | Ïîäï. | Äàòà | | | | | 0,09 | 2,5:1
Ðàçðàá. | Êîëåñíè÷åíêî Ð. Â.
Ïðîâ.
Ò.êîíòð. | | | | Ëèñò | Ëèñòîâ 1

Ñòàëü 40Õ ÃÎÑÒ 1050-88

Í.êîíòð.
Óòâ.
