ruslanrobotic/Dissertation/Test bench/Drawings/Bearing unit support.pdf

Ra 6,3

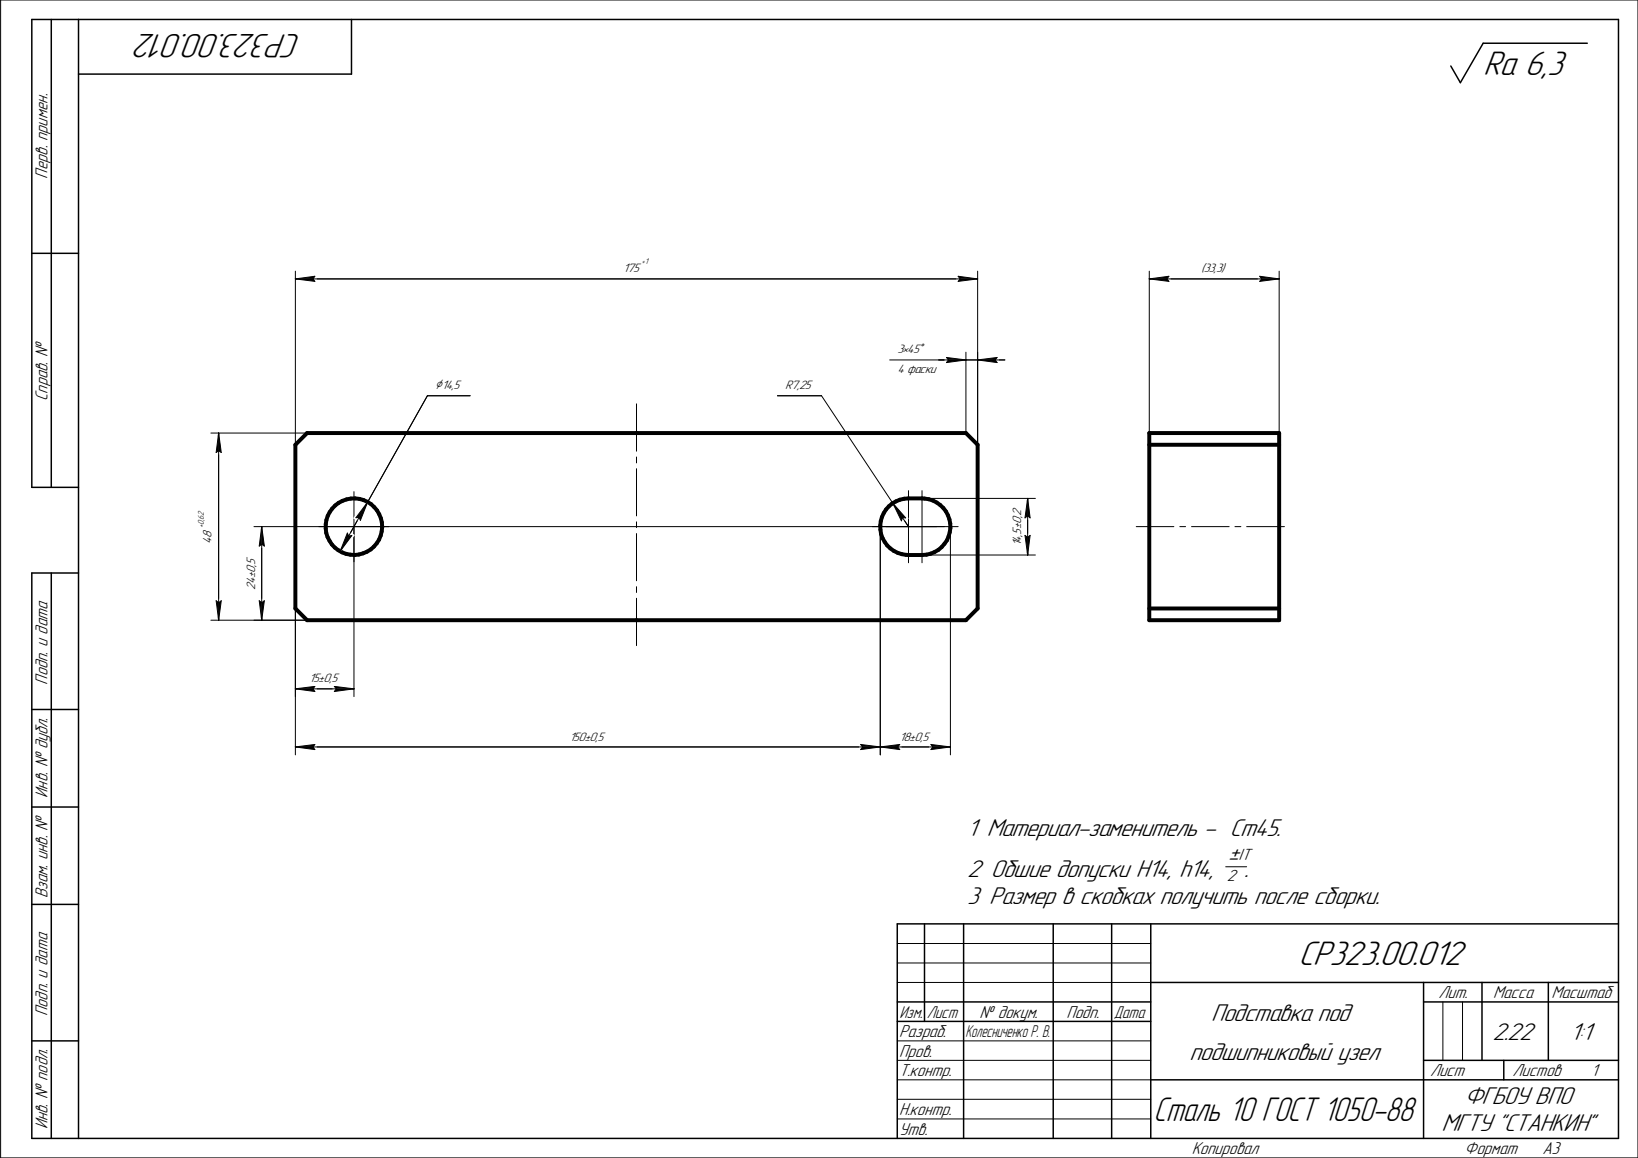
[picture p143: page 1]
4 ôàñêè; Êîïèðîâàë; Ôîðìàò

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

1 Ìàòåðèàë-çàìåíèòåëü - Ñò45.
. 3 Ðàçìåð â ñêîáêàõ ïîëó÷èòü ïîñëå ñáîðêè.
2 Îáøèå äîïóñêè H14, h14,

Ïîäñòàâêà ïîä ïîäøèïíèêîâûé óçåë | Ëèò. | Ìàññà | Ìàñøòàá

Èçì. Ëèñò | ¹ äîêóì. | Ïîäï. | Äàòà | | | | | 2.22 | 1:1
Ðàçðàá. | Êîëåñíè÷åíêî Ð. Â.
Ïðîâ.
Ò.êîíòð. | | | | Ëèñò | Ëèñòîâ 1

ÔÃÁÎÓ ÂÏÎ ÌÃÒÓ "ÑÒÀÍÊÈÍ" Ñòàëü 10 ÃÎÑÒ 1050-88

Í.êîíòð.
Óòâ.
