ruslanrobotic/Dissertation/Test bench/Drawings/Boom mounting to shaft.pdf

Ra 6,3

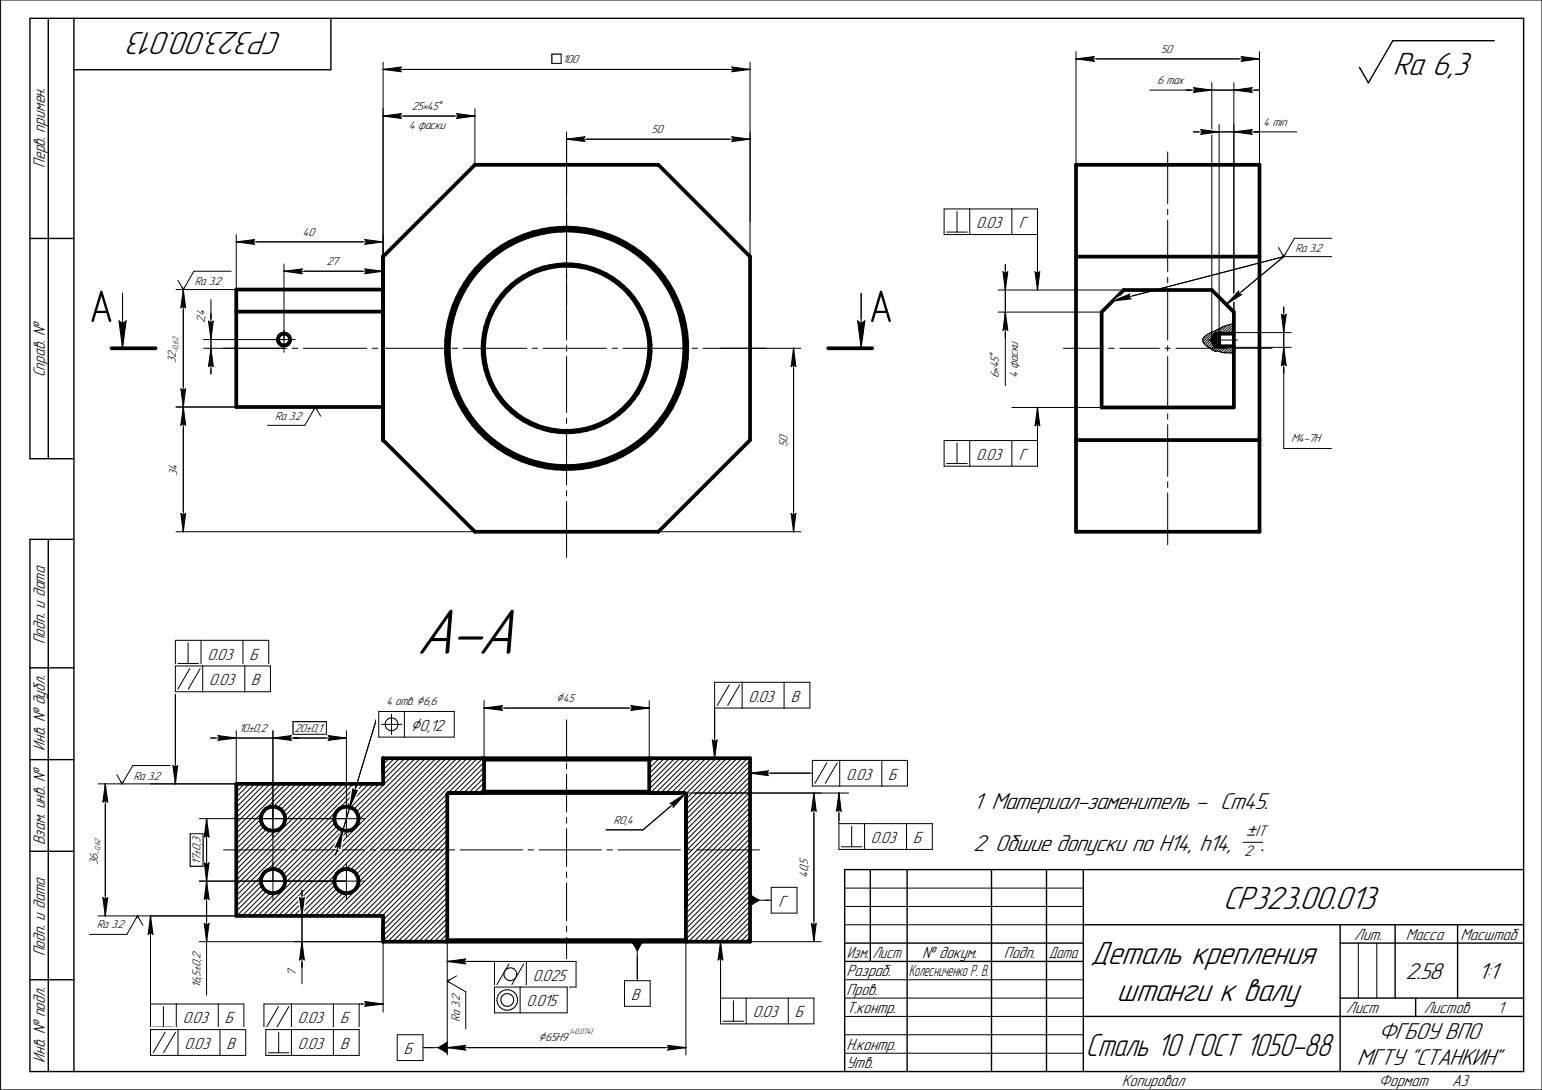
[picture p144: page 1]
4 îòâ.; 4 min; 4 ôàñêè; Ïðîâ.; Ò.êîíòð.; Ëèñò; Ëèñòîâ; Í.êîíòð.; Êîïèðîâàë; Ôîðìàò; 1 Ìàòåðèàë-çàìåíèòåëü - Ñò45.

6 max

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

0.03 | Á Á
0.03 | Â Â

2 Îáøèå äîïóñêè ïî H14, h14,

Äåòàëü êðåïëåíèÿ øòàíãè ê âàëó | Ëèò. | Ìàññà | Ìàñøòàá

Èçì. Ëèñò | ¹ äîêóì. | Ïîäï. | Äàòà | | | | | 2.58 | 1:1
Ðàçðàá. | Êîëåñíè÷åíêî Ð. Â.

ÔÃÁÎÓ ÂÏÎ ÌÃÒÓ "ÑÒÀÍÊÈÍ" Ñòàëü 10 ÃÎÑÒ 1050-88

Óòâ.
