ruslanrobotic/Dissertation/Test bench/Drawings/Bushing between bearings.pdf

Ra 6,3

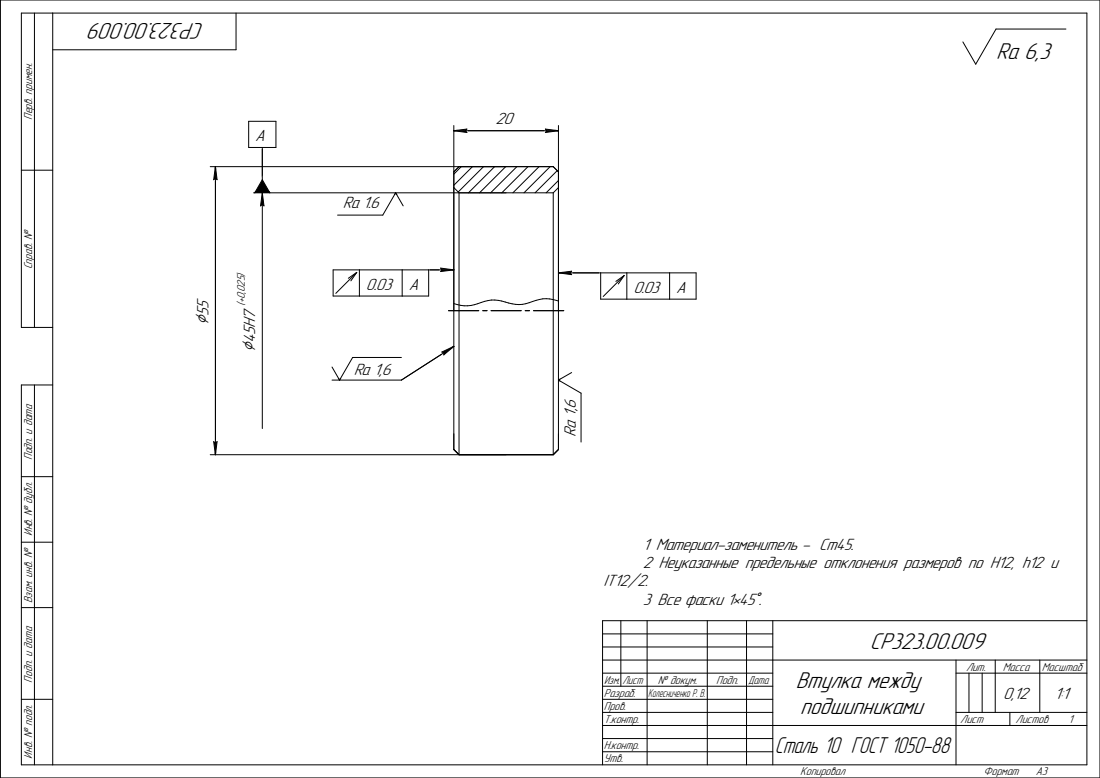
[picture p145: page 1]
Êîïèðîâàë; Ôîðìàò

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

1 Ìàòåðèàë-çàìåíèòåëü - Ñò45.
2 Íåóêàçàííûå ïðåäåëüíûå îòêëîíåíèÿ ðàçìåðîâ ïî H12, h12 è
3 Âñå ôàñêè 1•45

Âòóëêà ìåæäó ïîäøèïíèêàìè | Ëèò. | Ìàññà | Ìàñøòàá

Èçì. Ëèñò | ¹ äîêóì. | Ïîäï. | Äàòà | | | | | 0,12 | 1:1
Ðàçðàá. | Êîëåñíè÷åíêî Ð. Â.
Ïðîâ.
Ò.êîíòð. | | | | Ëèñò | Ëèñòîâ 1

Í.êîíòð.
Óòâ.

Ñòàëü 10 ÃÎÑÒ 1050-88
