ruslanrobotic/Dissertation/Test bench/Drawings/Bushing for attaching gear to the shaft.pdf

Ra 6,3

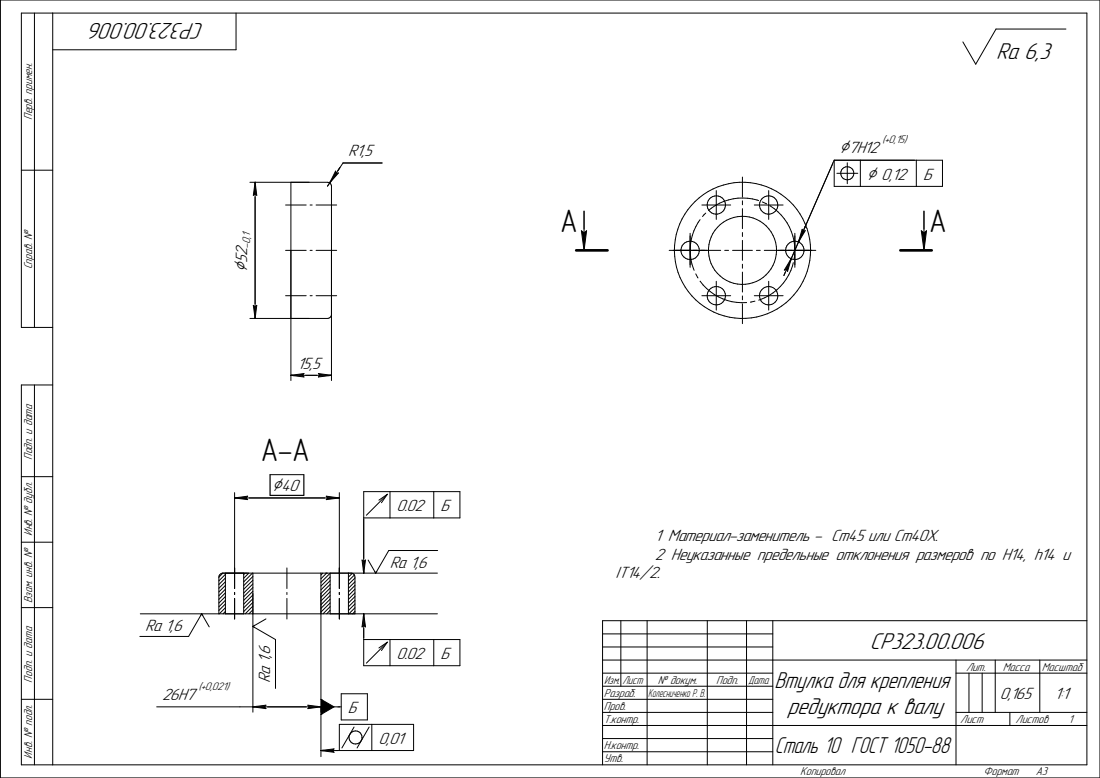
[picture p146: page 1]
Ñòàëü 10 ÃÎÑÒ 1050-88; Êîïèðîâàë; Ôîðìàò

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

Ç7H12⁽⁺⁰,15)
Ç 0,12 | Á Á

1 Ìàòåðèàë-çàìåíèòåëü - Ñò45 èëè Ñò40Õ.
2 Íåóêàçàííûå ïðåäåëüíûå îòêëîíåíèÿ ðàçìåðîâ ïî H14, h14 è

Âòóëêà äëÿ êðåïëåíèÿ ðåäóêòîðà ê âàëó | Ëèò. | Ìàññà | Ìàñøòàá

Èçì. Ëèñò | ¹ äîêóì. | Ïîäï. | Äàòà | | | | | 0,165 | 1:1
Ðàçðàá. | Êîëåñíè÷åíêî Ð. Â.
Ïðîâ.
Ò.êîíòð. | | | | Ëèñò | Ëèñòîâ 1

Í.êîíòð.
Óòâ.
