ruslanrobotic/Dissertation/Test bench/Drawings/Corner stand.pdf

À

À

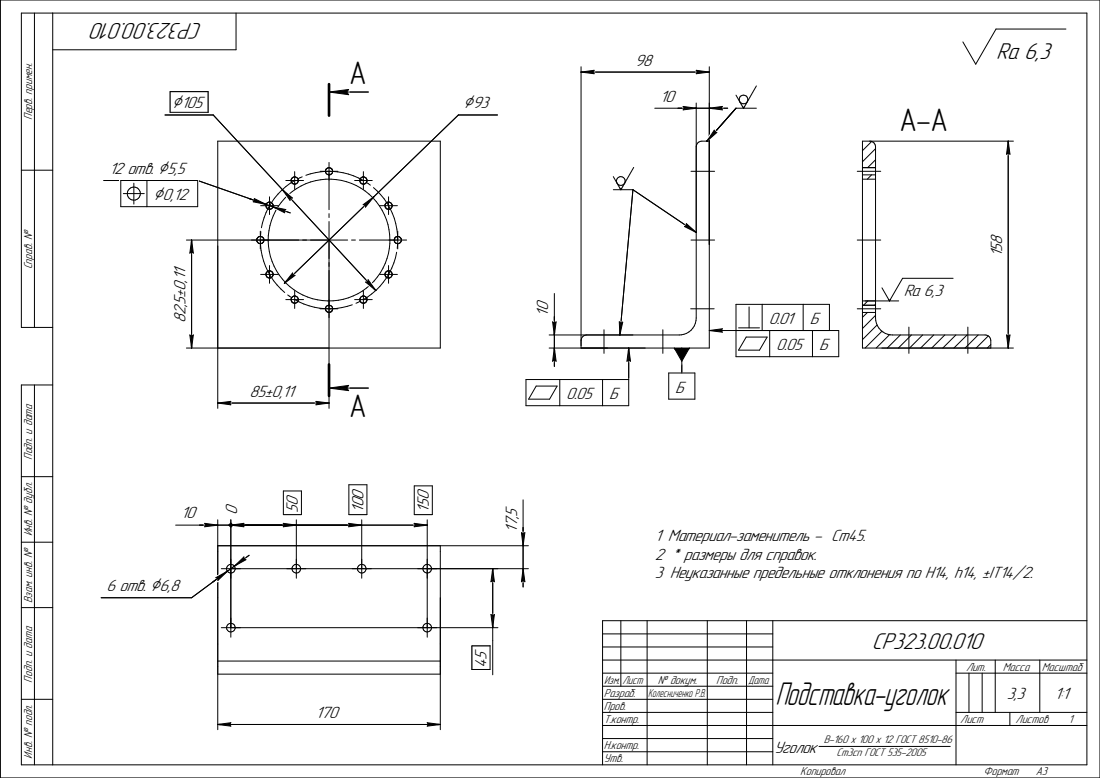
[picture p147: page 1]
12 îòâ.; 6 îòâ.; Èçì. Ëèñò; ¹ äîêóì.; Ïîäï.; Äàòà; Ðàçðàá.; Êîëåñíè÷åíêî Ð.Â.; Êîïèðîâàë; Ôîðìàò

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

0.01 | Á
0.05 | Á

1 Ìàòåðèàë-çàìåíèòåëü - Ñò45.
2 * ðàçìåðû äëÿ ñïðàâîê.
3 Íåóêàçàííûå ïðåäåëüíûå îòêëîíåíèÿ ïî H14, h14,

Ïîäñòàâêà-óãîëîê | Ëèò. | Ìàññà | Ìàñøòàá

Ïðîâ.
Ò.êîíòð. | | Ëèñò | Ëèñòîâ 1

Óãîëîê Â-160 x 100 x 12 ÃÎÑÒ 8510-86 Ñò3ñï ÃÎÑÒ 535-2005

Í.êîíòð.
Óòâ.
