ruslanrobotic/Dissertation/Test bench/Drawings/Enclosure 1.pdf

Á

Â

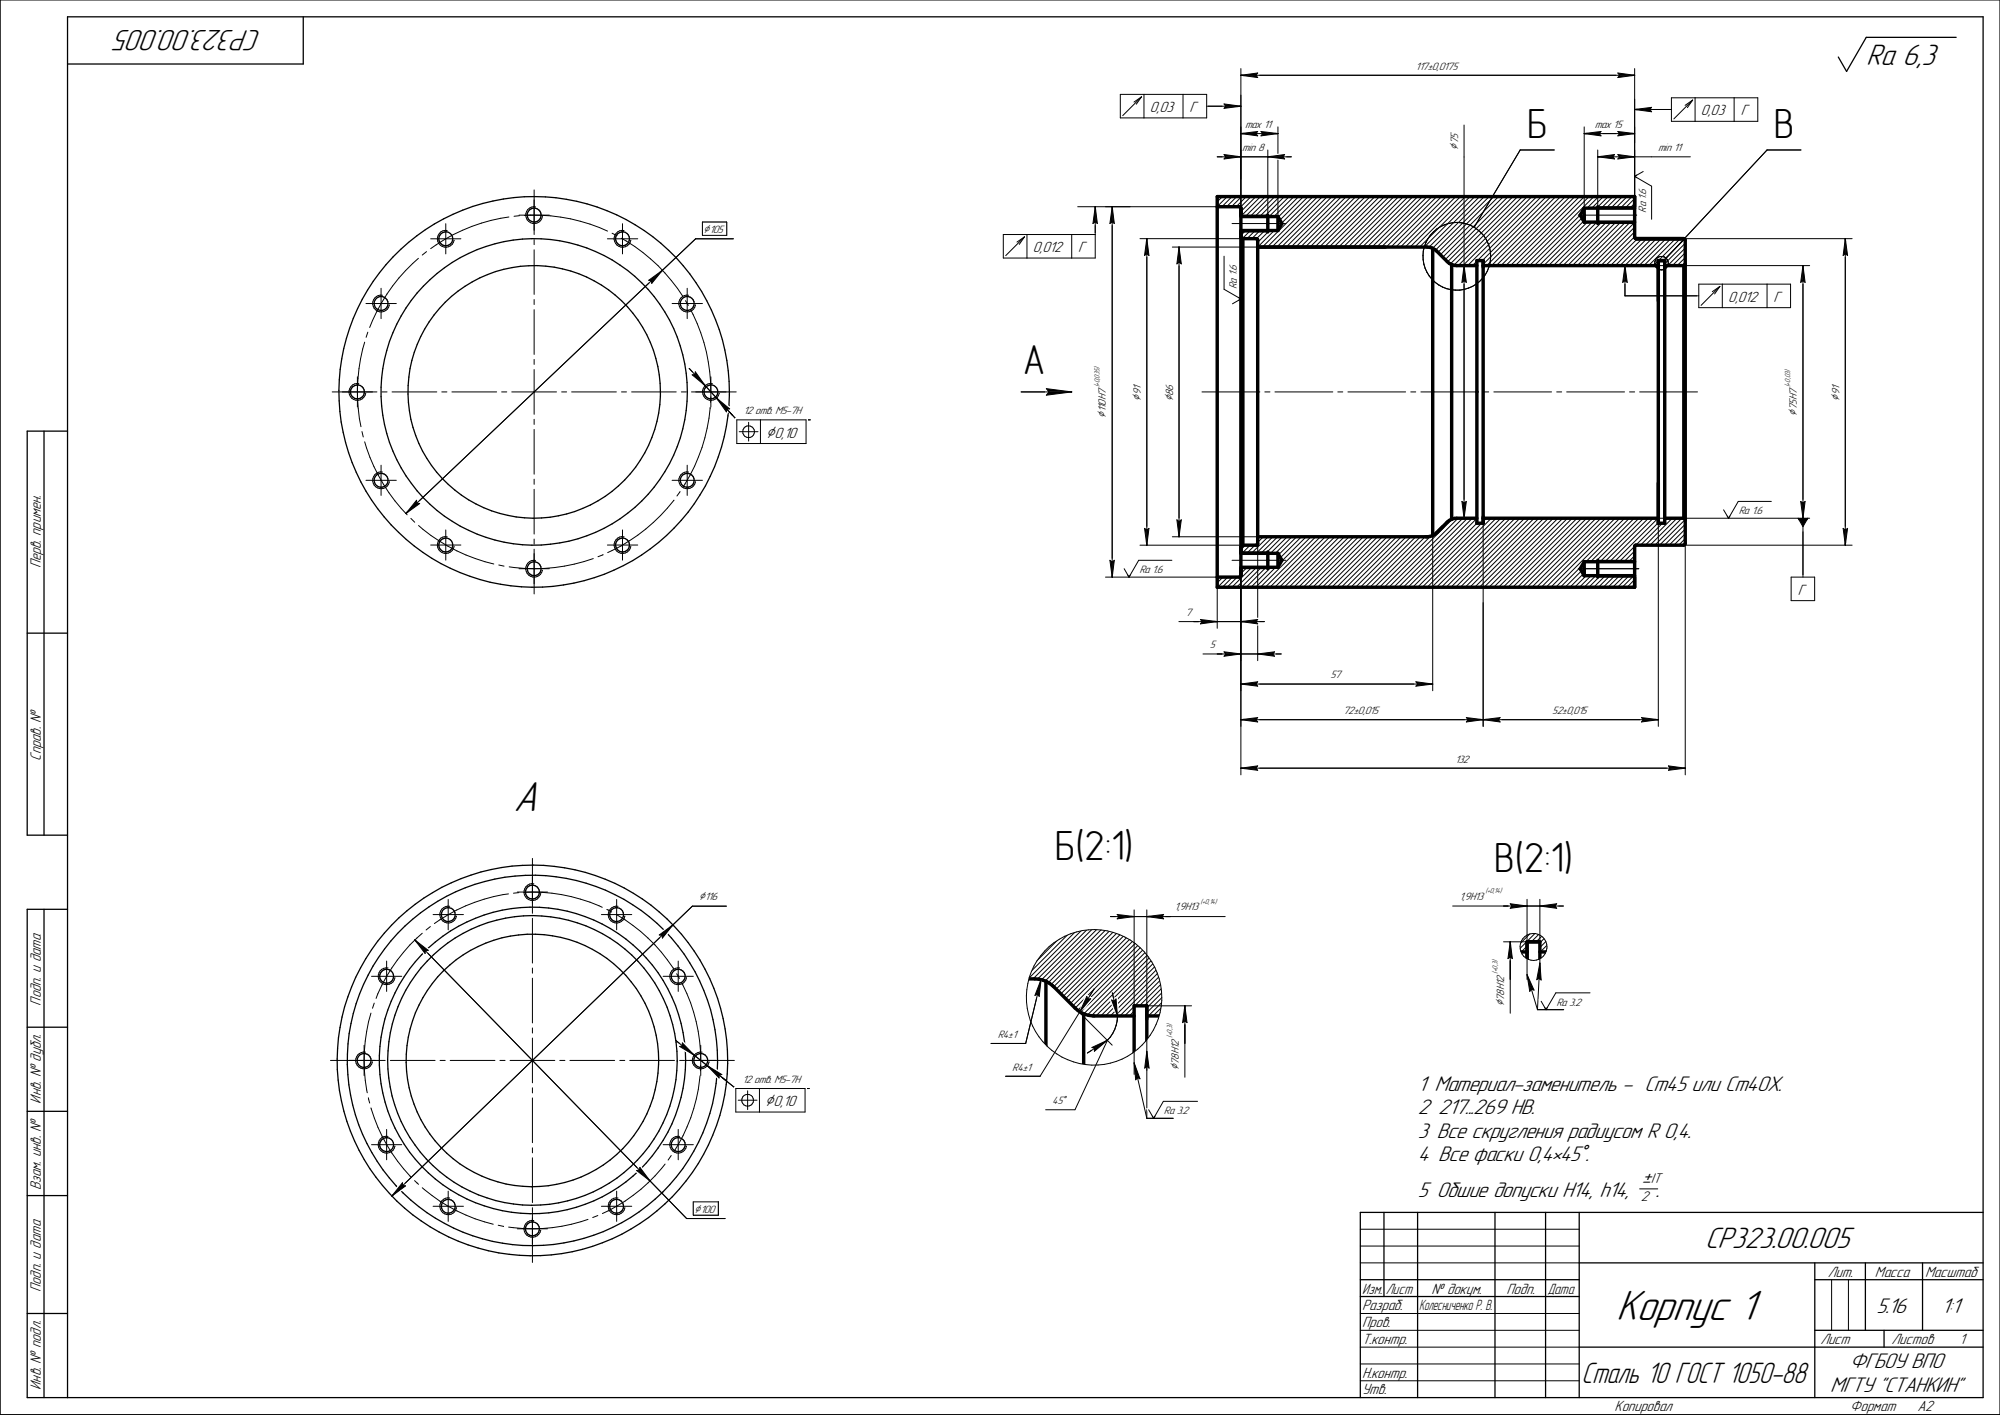
[picture p148: page 1]
min 11; max 15; min 8; max 11; 12 îòâ. M5-7H Ç0,10; Êîïèðîâàë; Ôîðìàò

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

1 Ìàòåðèàë-çàìåíèòåëü - Ñò45 èëè Ñò40Õ.
3 Âñå ñêðóãëåíèÿ ðàäèóñîì R 0,4.
Å. 5 Îáøèå äîïóñêè H14, h14,
4 Âñå ôàñêè 0,4•45

Ëèò. | Ìàññà | Ìàñøòàá

Èçì. Ëèñò | ¹ äîêóì. | Ïîäï. | Äàòà | | | | | 5.16 | 1:1
Ðàçðàá. | | | | Êîðïóñ 1 Êîëåñíè÷åíêî Ð. Â.

Ïðîâ.
Ò.êîíòð. | | | | Ëèñò | Ëèñòîâ 1

ÔÃÁÎÓ ÂÏÎ ÌÃÒÓ "ÑÒÀÍÊÈÍ" Ñòàëü 10 ÃÎÑÒ 1050-88

Í.êîíòð.
Óòâ.
