ruslanrobotic/Dissertation/Test bench/Drawings/Enclosure 2.pdf

Ra 6,3

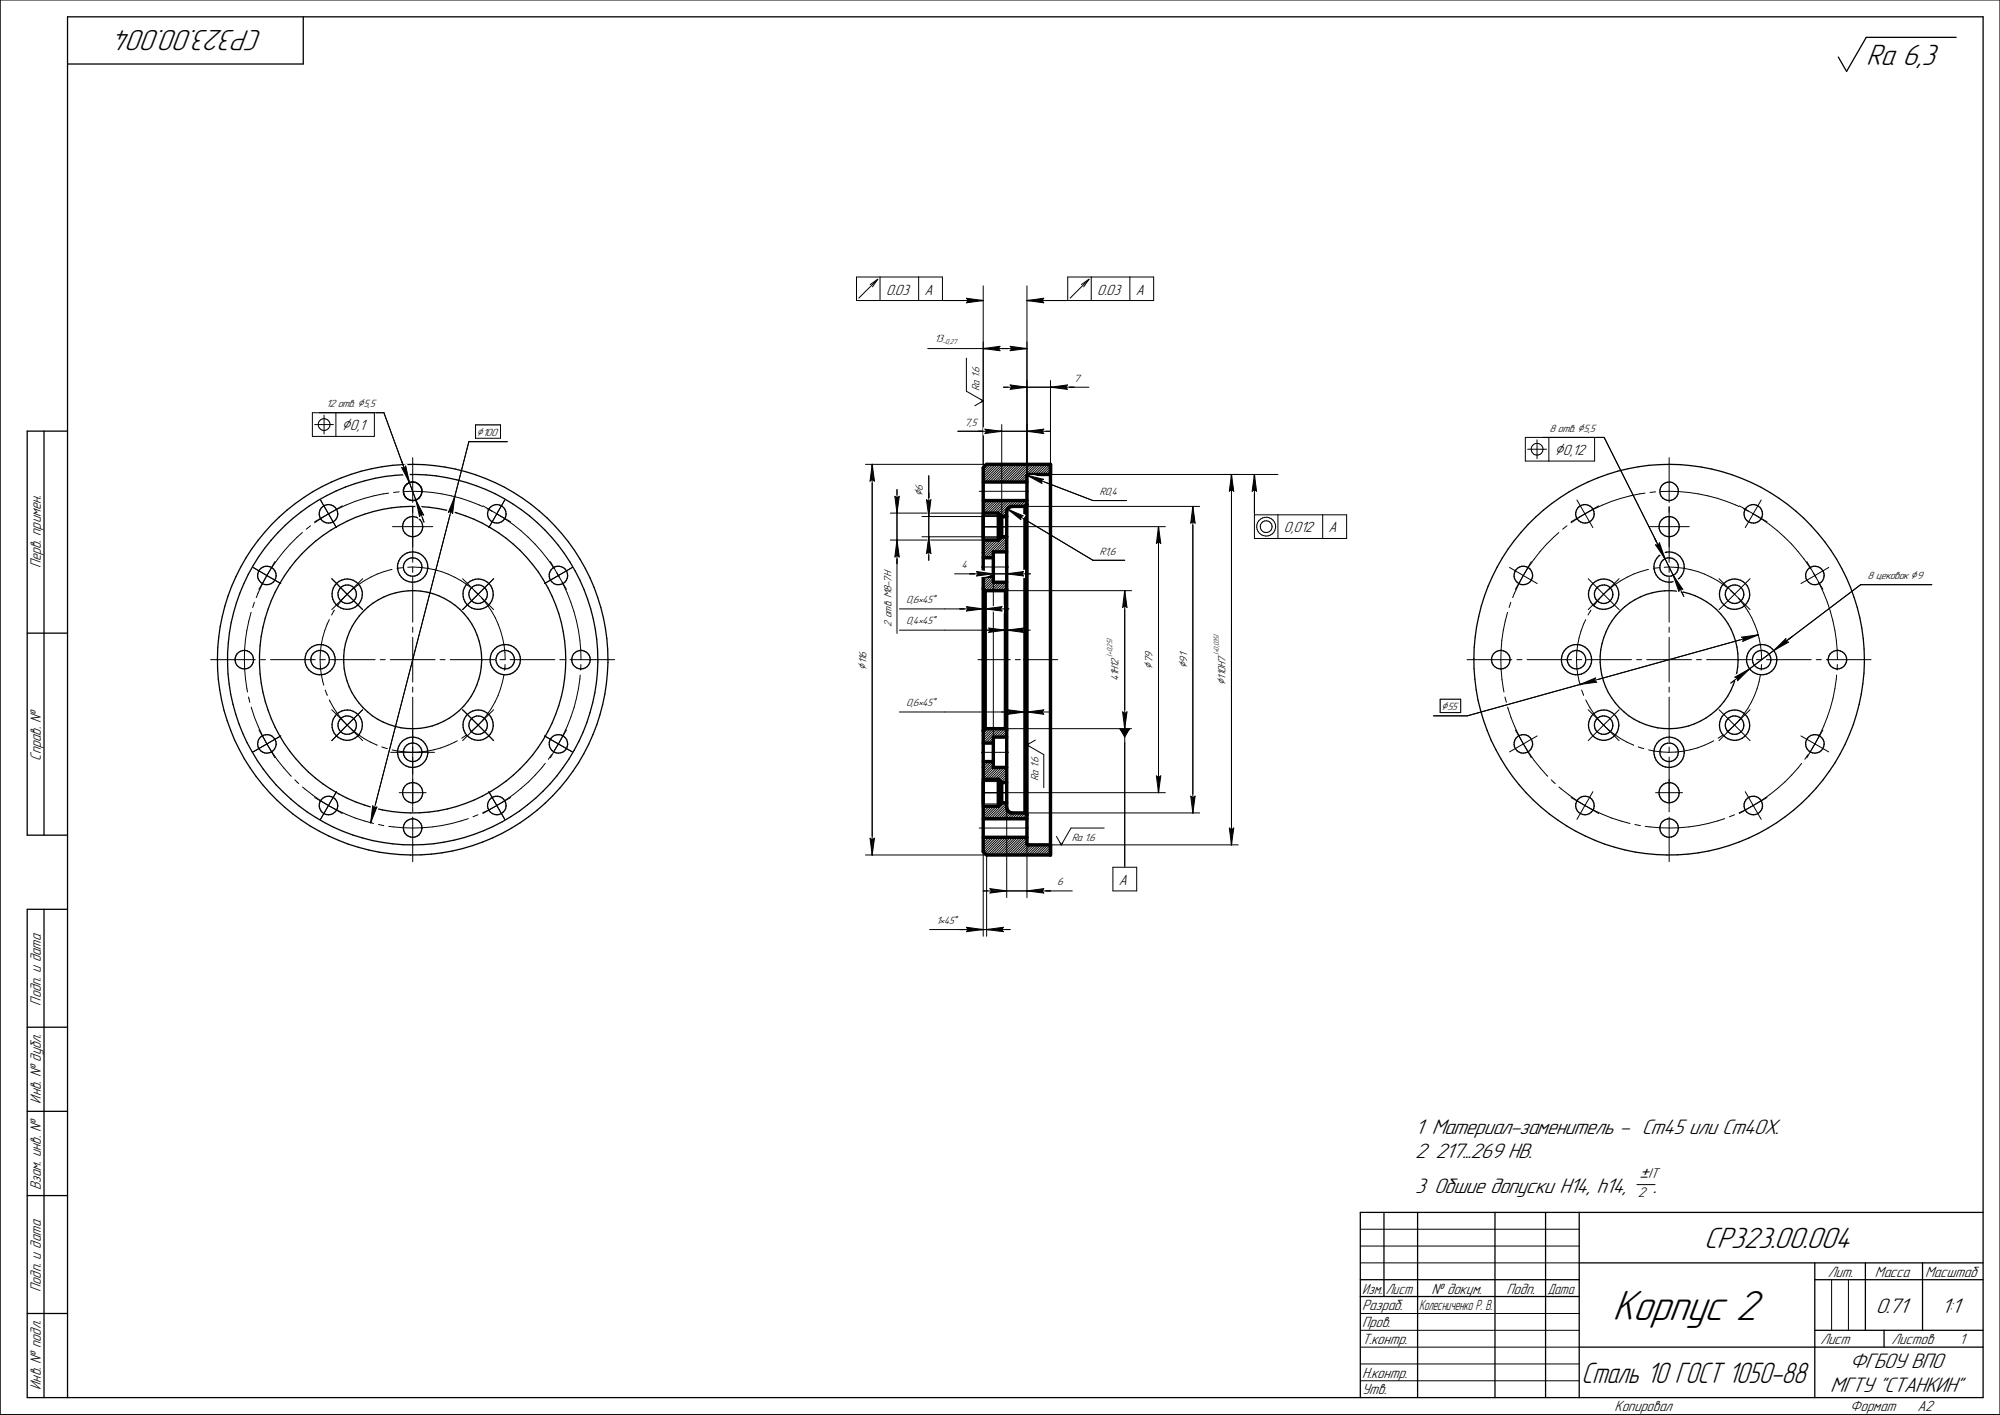
[picture p149: page 1]
8 öåêîâîê; 2 îòâ. M8-7H; 8 îòâ.; 12 îòâ.; Êîïèðîâàë; Ôîðìàò

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

1 Ìàòåðèàë-çàìåíèòåëü - Ñò45 èëè Ñò40Õ.
3 Îáøèå äîïóñêè H14, h14,

Ëèò. | Ìàññà | Ìàñøòàá

Èçì. Ëèñò | ¹ äîêóì. | Ïîäï. | Äàòà | | | | | 0.71 | 1:1
Ðàçðàá. | | | | Êîðïóñ 2 Êîëåñíè÷åíêî Ð. Â.

Ïðîâ.
Ò.êîíòð. | | | | Ëèñò | Ëèñòîâ 1

ÔÃÁÎÓ ÂÏÎ ÌÃÒÓ "ÑÒÀÍÊÈÍ" Ñòàëü 10 ÃÎÑÒ 1050-88

Í.êîíòð.
Óòâ.
