ruslanrobotic/Dissertation/Test bench/Drawings/Enclosure 4.pdf

Â
Ã

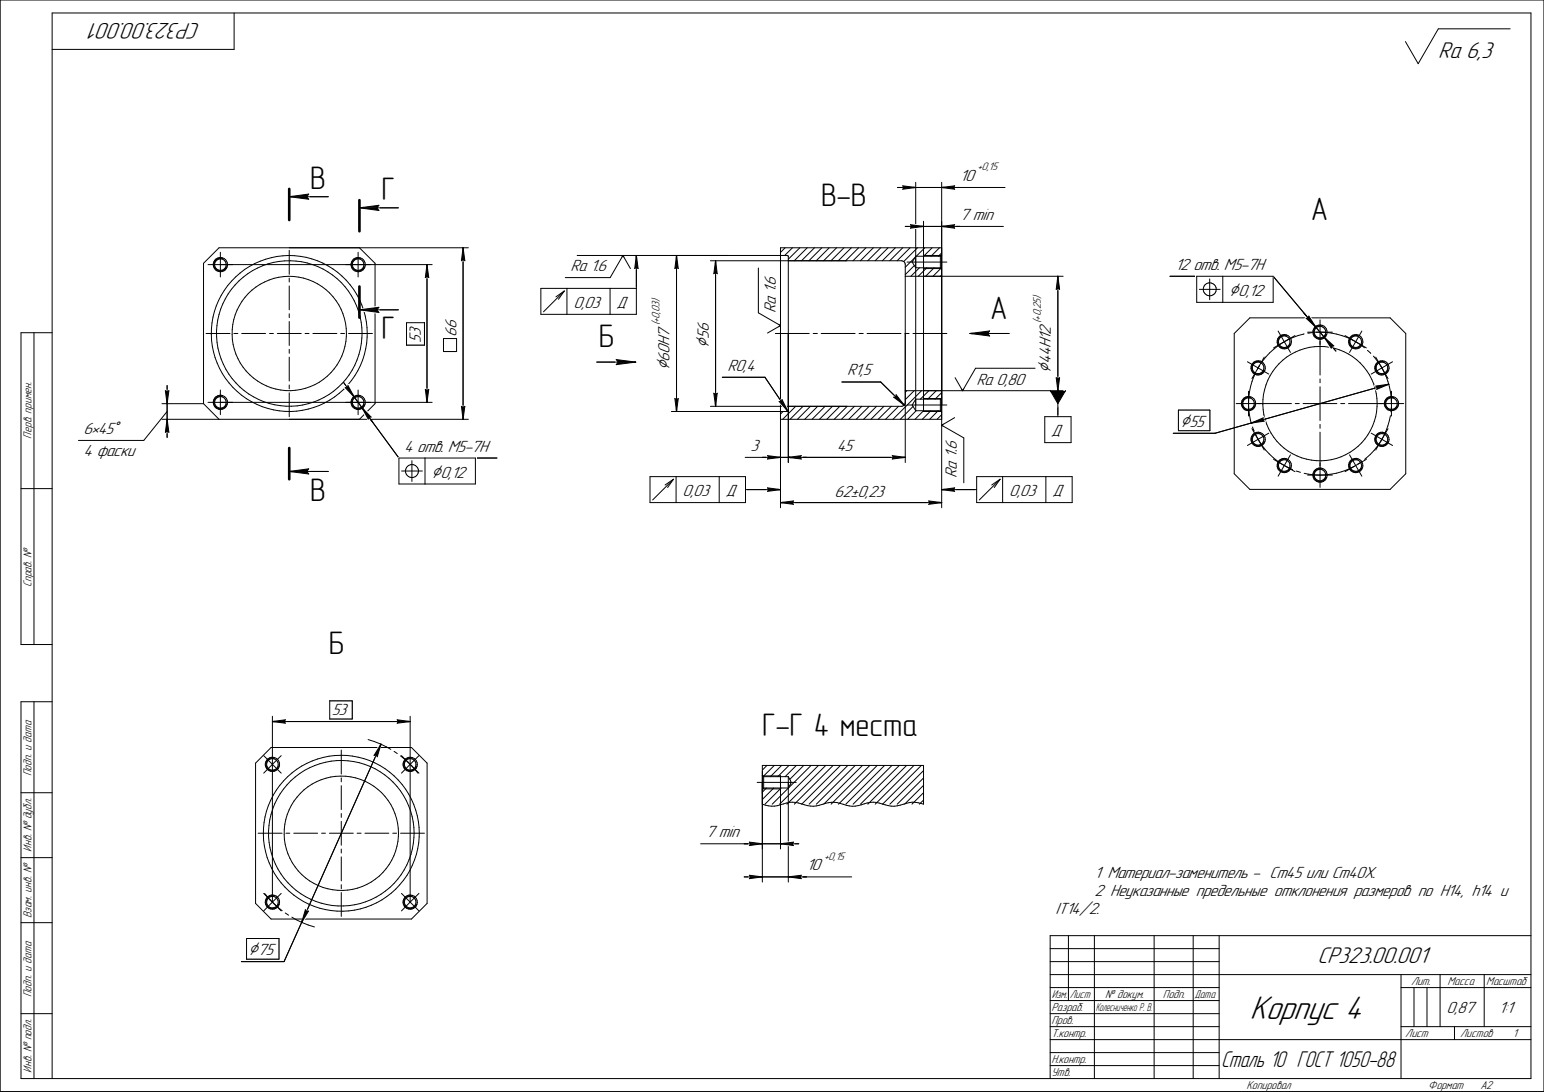
[picture p150: page 1]
4 îòâ. M5-7H Ç0,12; 4 ôàñêè; 7 min; 12 îòâ. M5-7H; Ã-Ã 4 ìåñòà; Êîïèðîâàë; Ôîðìàò

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

1 Ìàòåðèàë-çàìåíèòåëü - Ñò45 èëè Ñò40Õ.
2 Íåóêàçàííûå ïðåäåëüíûå îòêëîíåíèÿ ðàçìåðîâ ïî H14, h14 è

Êîðïóñ 4 | Ëèò. | Ìàññà | Ìàñøòàá

Èçì. Ëèñò | ¹ äîêóì. | Ïîäï. | Äàòà | | | | | 0,87 | 1:1
Ðàçðàá. | Êîëåñíè÷åíêî Ð. Â.
Ïðîâ.
Ò.êîíòð. | | | | Ëèñò | Ëèñòîâ 1

Ñòàëü 10 ÃÎÑÒ 1050-88

Í.êîíòð.
Óòâ.
