ruslanrobotic/Dissertation/Test bench/Drawings/Extra load bar.pdf

Ra 6,3

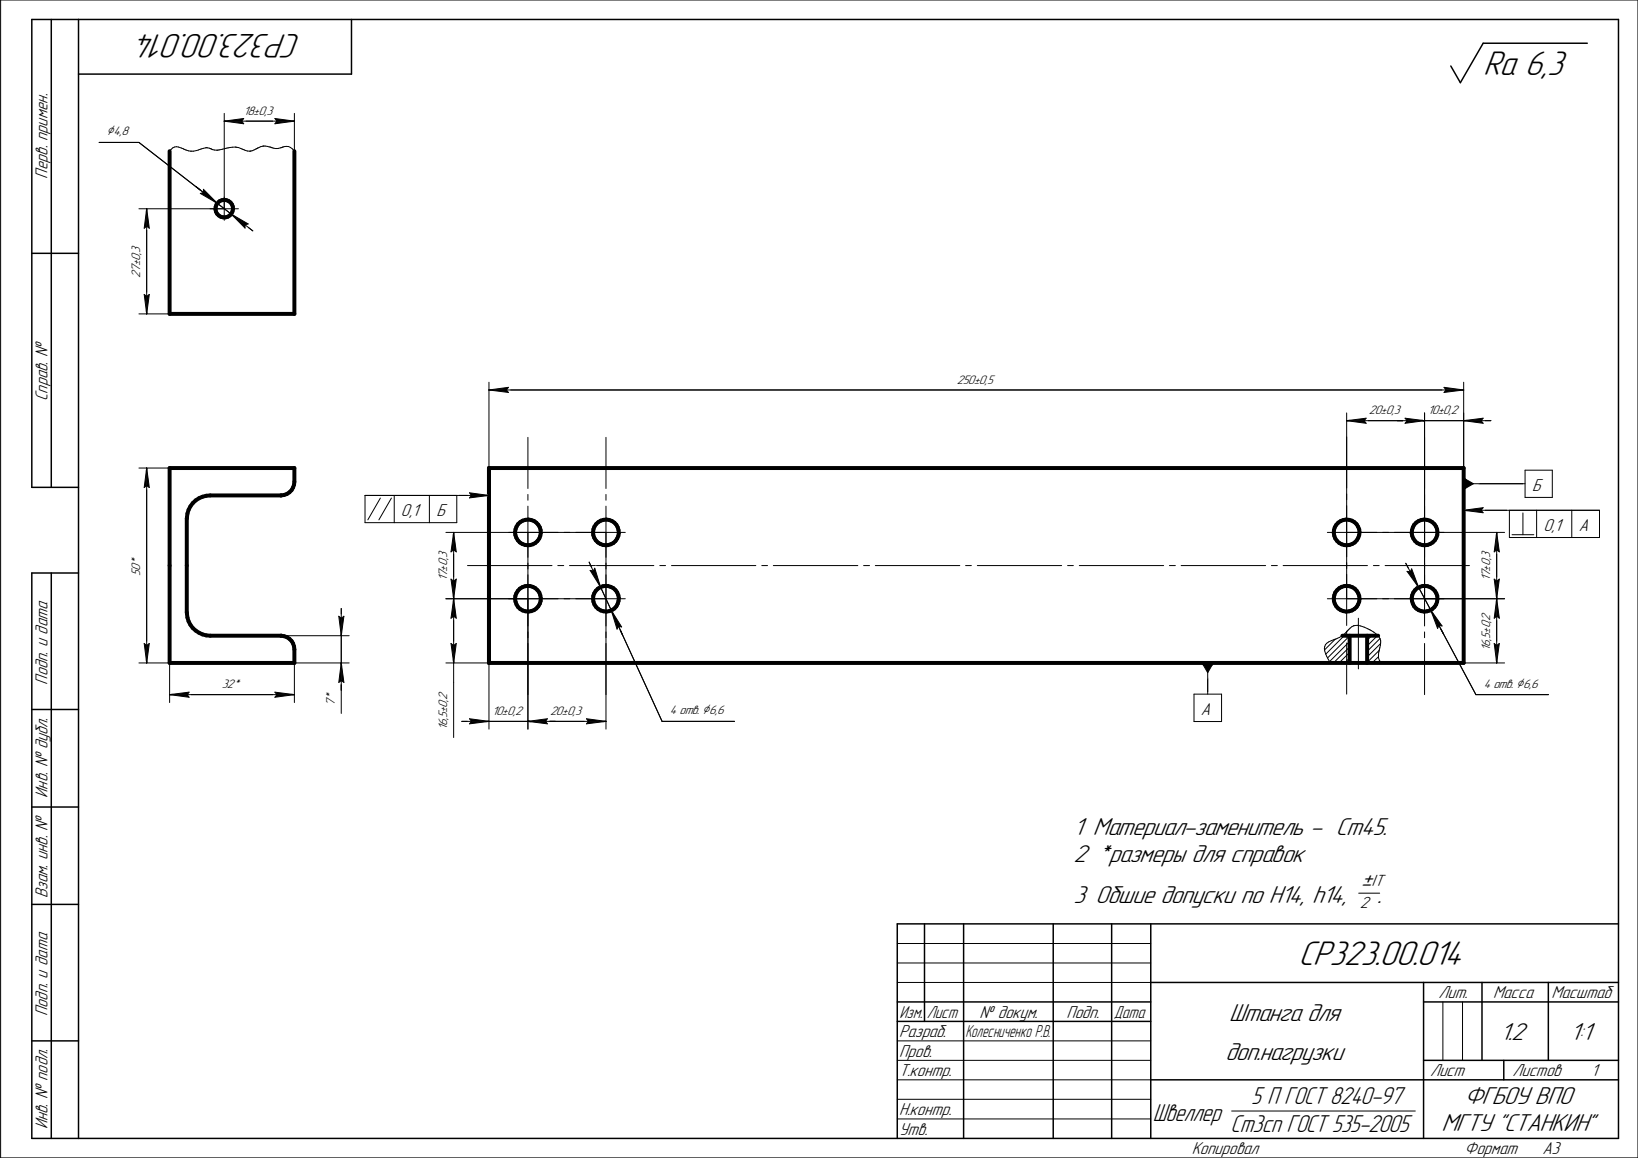
[picture p151: page 1]
4 îòâ.; Êîïèðîâàë; Ôîðìàò

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

1 Ìàòåðèàë-çàìåíèòåëü - Ñò45.
2 *ðàçìåðû äëÿ ñïðàâîê

3 Îáøèå äîïóñêè ïî H14, h14,

Øòàíãà äëÿ äîï.íàãðóçêè | Ëèò. | Ìàññà | Ìàñøòàá

Èçì. Ëèñò | ¹ äîêóì. | Ïîäï. | Äàòà | | | | | 1.2 | 1:1
Ðàçðàá. | Êîëåñíè÷åíêî Ð.Â.
Ïðîâ.
Ò.êîíòð. | | | | Ëèñò | Ëèñòîâ 1

5 Ï ÃÎÑÒ 8240-97 Ñò3ñï ÃÎÑÒ 535-2005 | ÔÃÁÎÓ ÂÏÎ ÌÃÒÓ "ÑÒÀÍÊÈÍ" Øâåëëåð

Í.êîíòð.
Óòâ.
