ruslanrobotic/Dissertation/Test bench/Drawings/Main shaft of the torque loader.pdf

À | Á | Â
| Á | Â

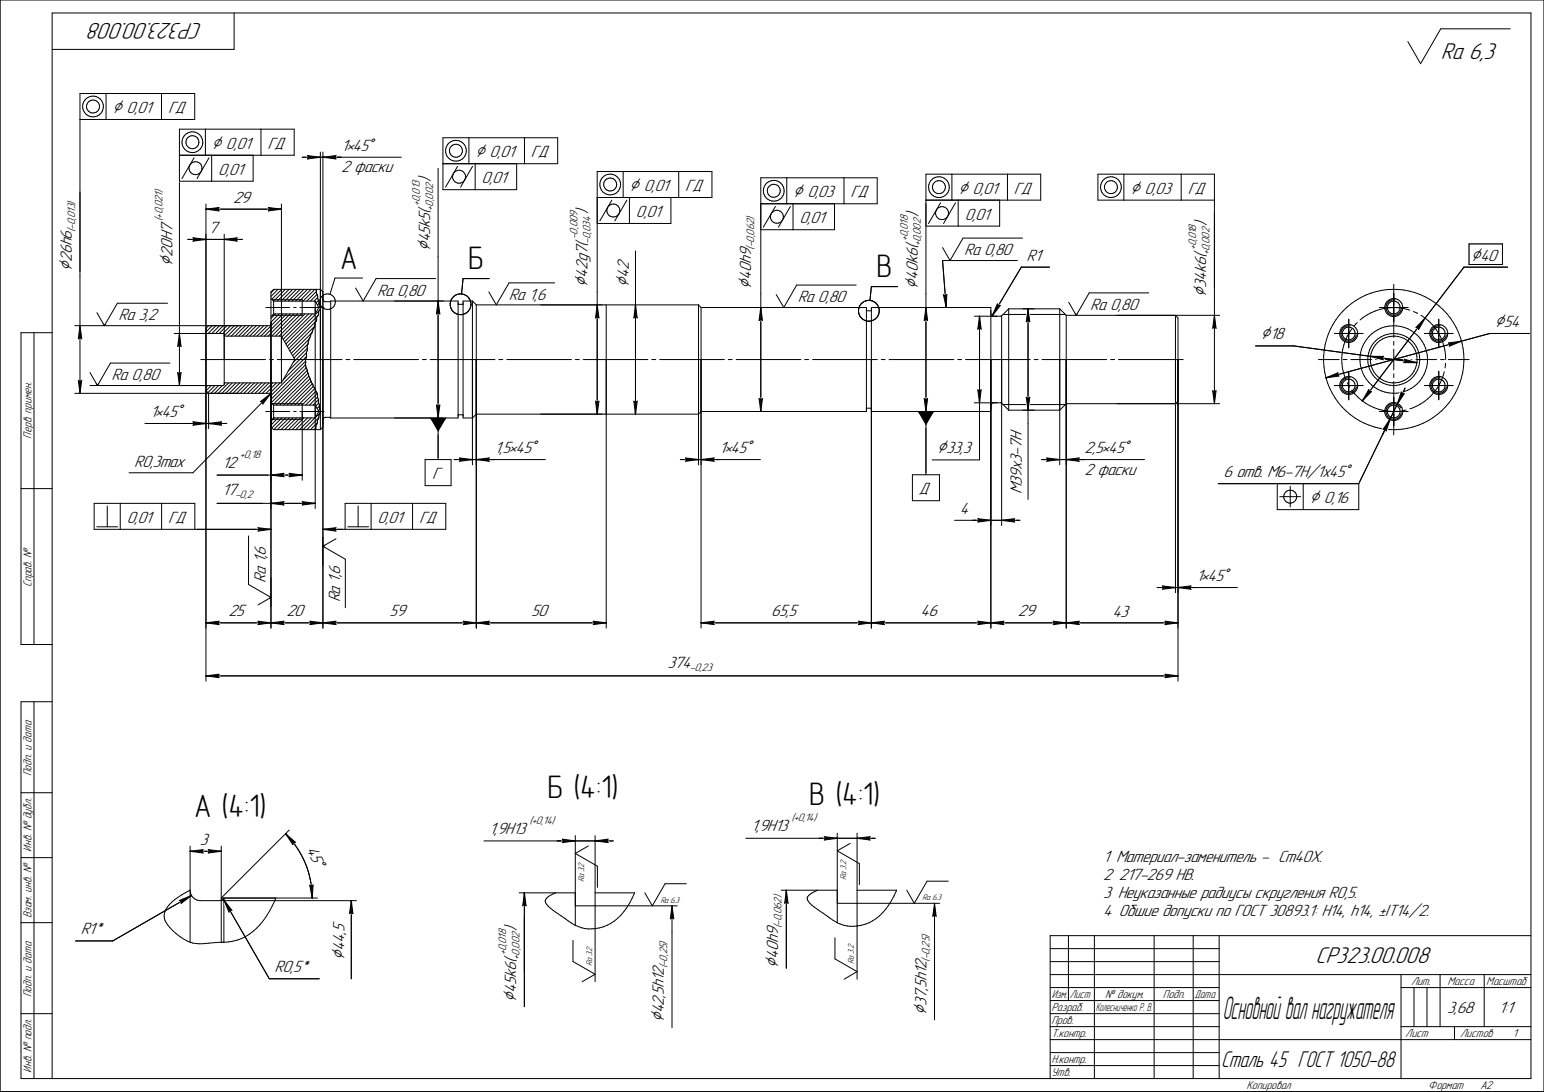
[picture p152: page 1]
2 ôàñêè; R0,3max; 6 îòâ. M6-7H/1x45Å; Êîïèðîâàë; Ôîðìàò

Ç 0,01 | ÃÄ
0,01

Ç 0,03 | ÃÄ

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

1 Ìàòåðèàë-çàìåíèòåëü - Ñò40Õ.
3 Íåóêàçàííûå ðàäèóñû ñêðóãëåíèÿ R0,5.
4 Îáøèå äîïóñêè ïî ÃÎÑÒ 30893.1: H14, h14, ±IT14/2.

Îñíîâíîé âàë íàãðóæàòåëÿ | Ëèò. | Ìàññà | Ìàñøòàá

Èçì. Ëèñò | ¹ äîêóì. | Ïîäï. | Äàòà | | | | | 3,68 | 1:1
Ðàçðàá. | Êîëåñíè÷åíêî Ð. Â.
Ïðîâ.
Ò.êîíòð. | | | | Ëèñò | Ëèñòîâ 1

Ñòàëü 45 ÃÎÑÒ 1050-88

Í.êîíòð.
Óòâ.
