ruslanrobotic/Dissertation/Test bench/Drawings/Rod attachment to the axle.pdf

À | À

À

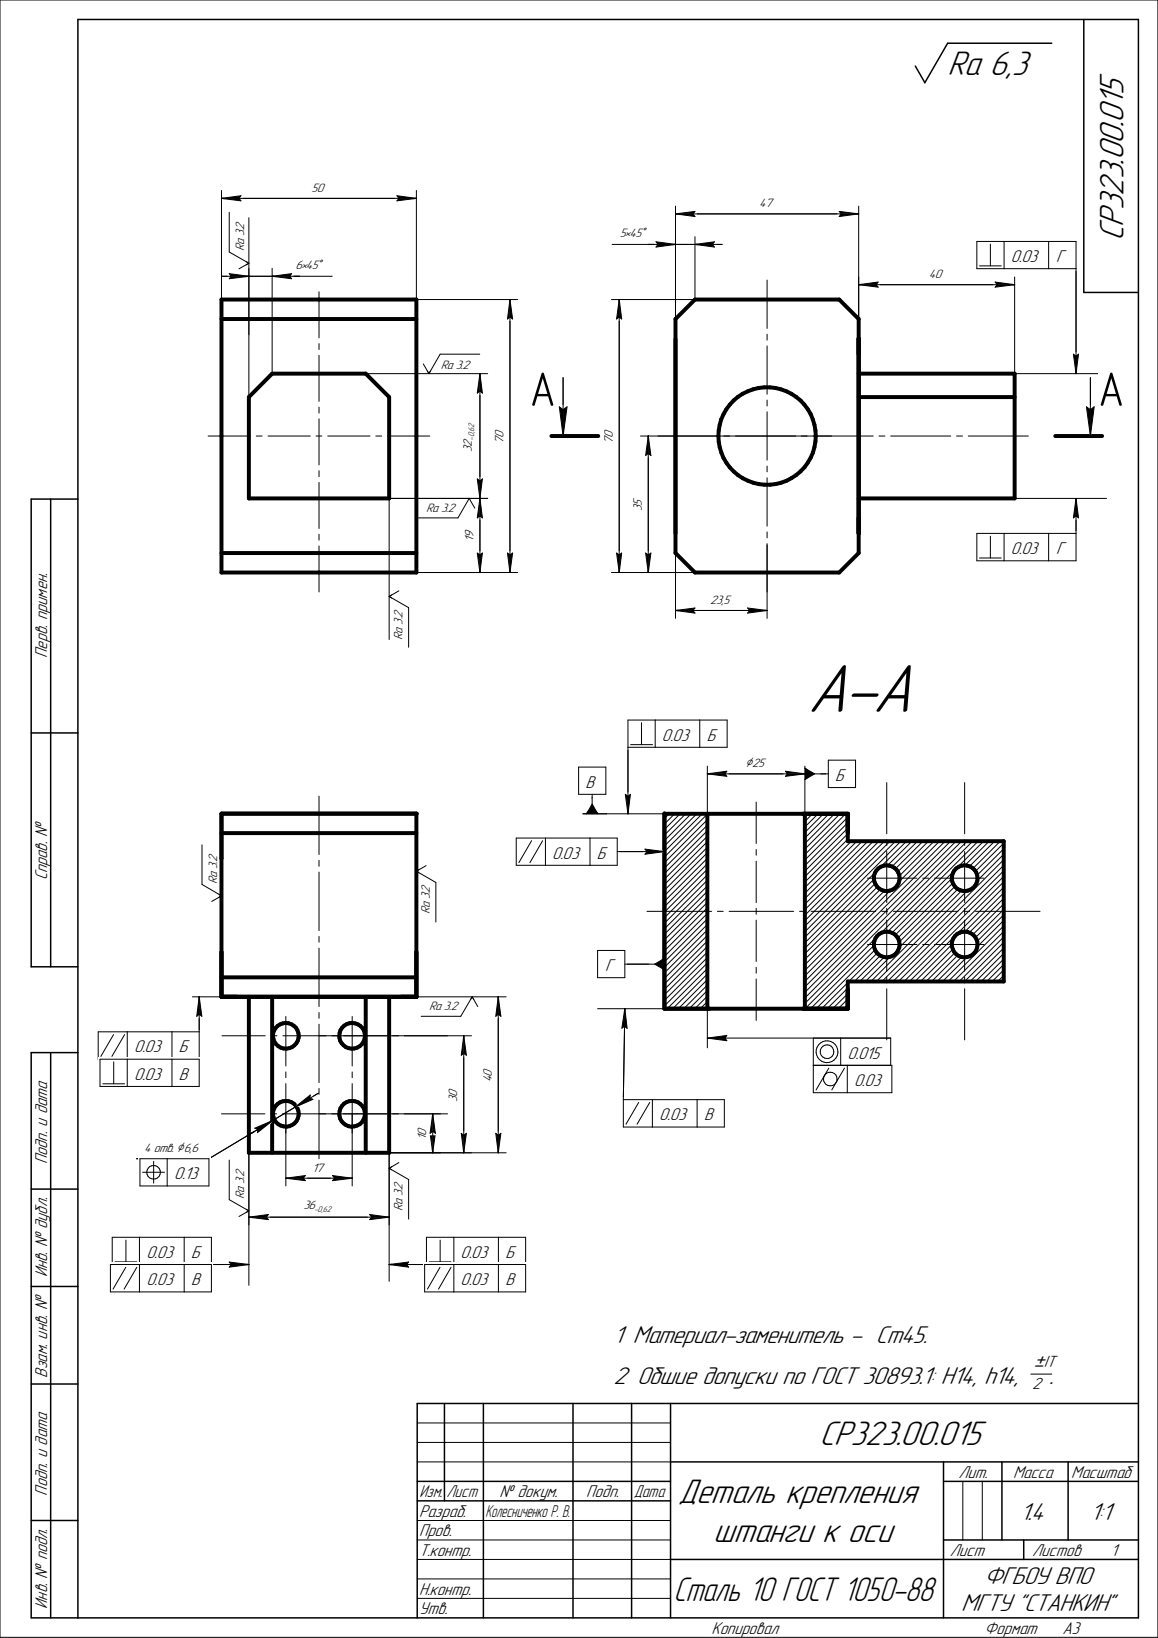
[picture p153: page 1]
4 îòâ.; Êîïèðîâàë; Ôîðìàò; 1 Ìàòåðèàë-çàìåíèòåëü - Ñò45.

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

0.03 | Á Á
0.03 | Â Â

2 Îáøèå äîïóñêè ïî ÃÎÑÒ 30893.1: H14, h14,

Äåòàëü êðåïëåíèÿ øòàíãè ê îñè | Ëèò. | Ìàññà | Ìàñøòàá

Èçì. Ëèñò | ¹ äîêóì. | Ïîäï. | Äàòà | | | | | 1.4 | 1:1 1
Ðàçðàá. | Êîëåñíè÷åíêî Ð. Â.
Ïðîâ.
Ò.êîíòð. | | | | Ëèñò | Ëèñòîâ

Ñòàëü 10 ÃÎÑÒ 1050-88 | ÔÃÁÎÓ ÂÏÎ ÌÃÒÓ "ÑÒÀÍÊÈÍ"

Í.êîíòð.
Óòâ.
