ruslanrobotic/Dissertation/Test bench/Drawings/Sensor Support.pdf

Ra 6,3

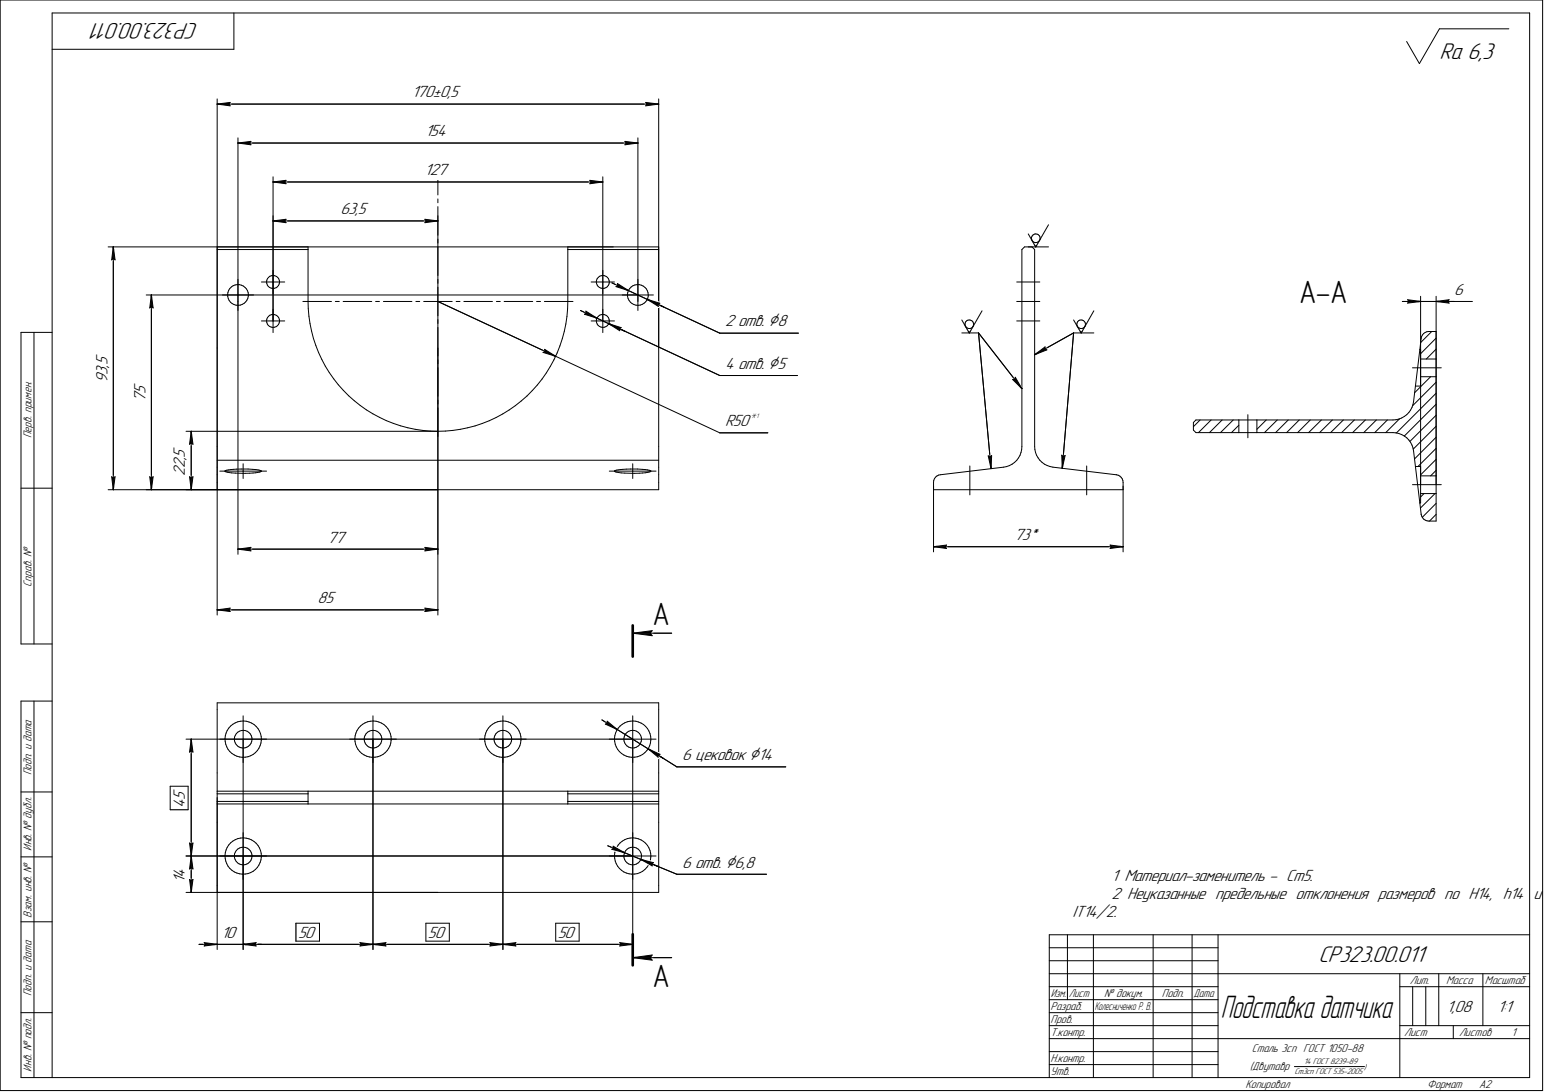
[picture p154: page 1]
2 îòâ.; 4 îòâ.; 6 îòâ.; 6 öåêîâîê; Êîïèðîâàë; Ôîðìàò

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

1 Ìàòåðèàë-çàìåíèòåëü - Ñò5.
2 Íåóêàçàííûå ïðåäåëüíûå îòêëîíåíèÿ ðàçìåðîâ ïî H14, h14 è

Ïîäñòàâêà äàò÷èêà | Ëèò. | Ìàññà | Ìàñøòàá

Èçì. Ëèñò | ¹ äîêóì. | Ïîäï. | Äàòà | | | | | 1,08 | 1:1
Ðàçðàá. | Êîëåñíè÷åíêî Ð. Â.
Ïðîâ.
Ò.êîíòð. | | | | Ëèñò | Ëèñòîâ 1

Ñòàëü 3ñï ÃÎÑÒ 1050-88 (Äâóòàâð 14 ÃÎÑÒ 8239-89 Ñò3ñï ÃÎÑÒ 535-2005 )

Í.êîíòð.
Óòâ.
