ruslanrobotic/Dissertation/Test bench/Drawings/Short main shaft.pdf

À
Á

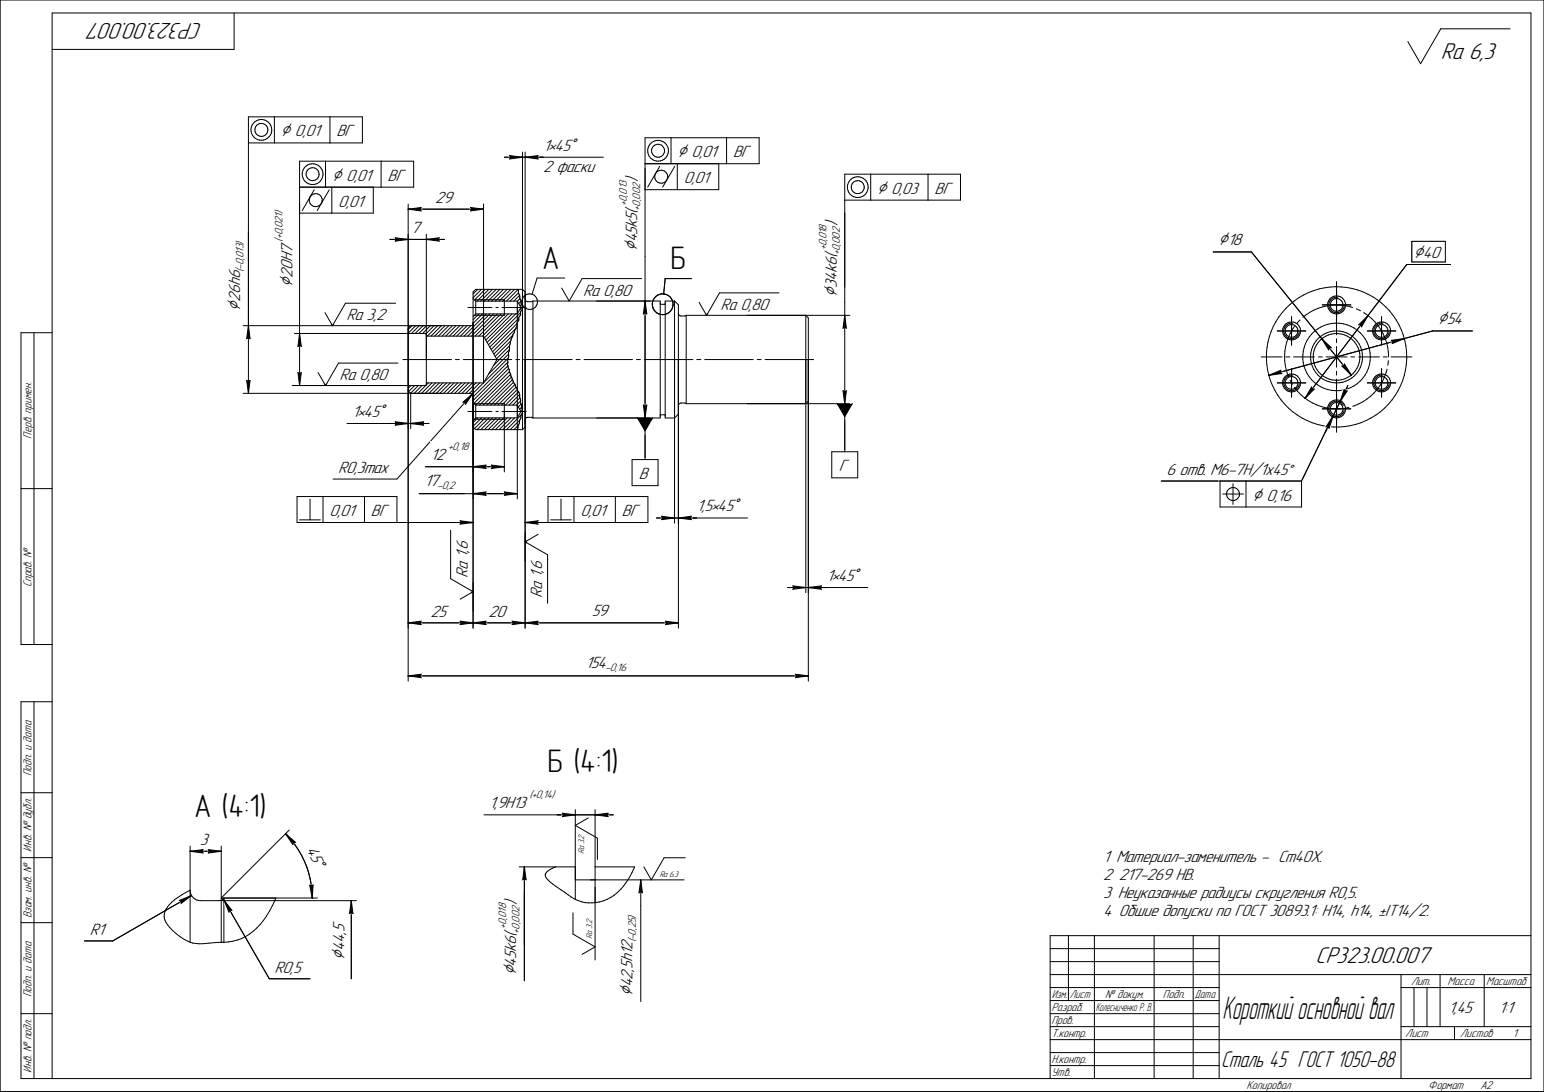
[picture p155: page 1]
2 ôàñêè; R0,3max; 6 îòâ. M6-7H/1x45°; Êîïèðîâàë; Ôîðìàò

0,01

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

Êîðîòêèé îñíîâíîé âàë | Ëèò. | Ìàññà | Ìàñøòàá

Èçì. Ëèñò | ¹ äîêóì. | Ïîäï. | Äàòà | | | | | 1,45 | 1:1
Ðàçðàá. | Êîëåñíè÷åíêî Ð. Â.
Ïðîâ.
Ò.êîíòð. | | | | Ëèñò | Ëèñòîâ 1

Ñòàëü 45 ÃÎÑÒ 1050-88

Í.êîíòð.
Óòâ.
