ruslanrobotic/Dissertation/(commit log)

2023-08-21 Added results
    [1.CSV, AA.csv, AAA.csv, AAB.csv, AAC.csv, AAD.csv, AAE.csv, AAF.csv]
2025-05-01 Added test bench drawings
    [1.CSV, AA.csv, AAA.csv, AAB.csv, AAC.csv, AAD.csv, AAE.csv, AAF.csv]
2025-05-02 Added CAD model with CAE simulation results
    [Angle_bar.SLDPRT, Angle_bar_2.SLDPRT, Baugruppe_026.SLDASM, Baugruppe_027.SLDASM, Bear 8338_200_gost.SLDPRT, Bear 8338_200_gost_2.SLDPRT, Bear 8338_200_gost_3.SLDPRT, Bush_2.SLDPRT]
